sloboste/eecs473-fitness-watch/watch_app/README.md

Sample Dashboard App for Eir Watch
===================================

This sample demonstrates how to use the Bluetooth LE to connect to the Eir Watch with an Android device.

Introduction
------------

This sample shows a list of available Bluetooth LE devices and provides
an interface to connect, display data and display GATT services and
characteristics supported by the devices.

It creates a [Service][1] for managing connection and data communication with a GATT server
hosted on a given Bluetooth LE device.

The Activities communicate with the Service, which in turn interacts with the [Bluetooth LE API][2].

[1]:http://developer.android.com/reference/android/app/Service.html
[2]:https://developer.android.com/reference/android/bluetooth/BluetoothGatt.html

Pre-requisites
--------------

- Android SDK v23
- Android Build Tools v23.0.2
- Android Support Repository

Screenshots
-------------

  

Getting Started
---------------

Create a new project in Android studio and download the files into Application/Src/
