sloboste/eecs473-fitness-watch/docs/SoC/nRF51822-mKIT_Pinout.png

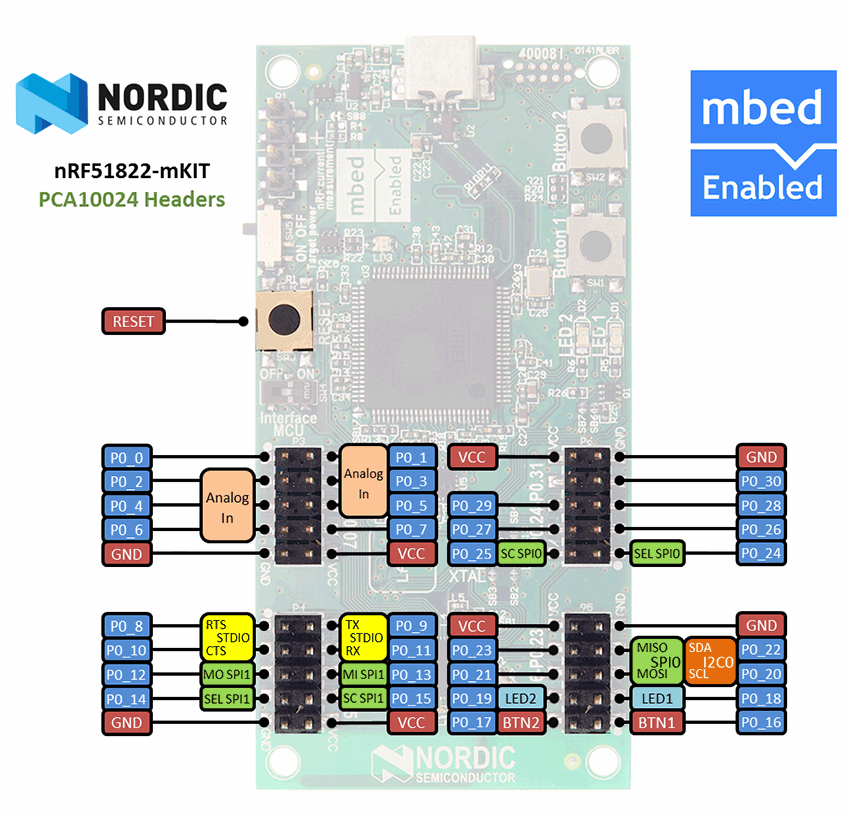
docs/SoC/nRF51822-mKIT_Pinout.png
