sloboste/eecs473-fitness-watch/solidworks/All.SLDASM

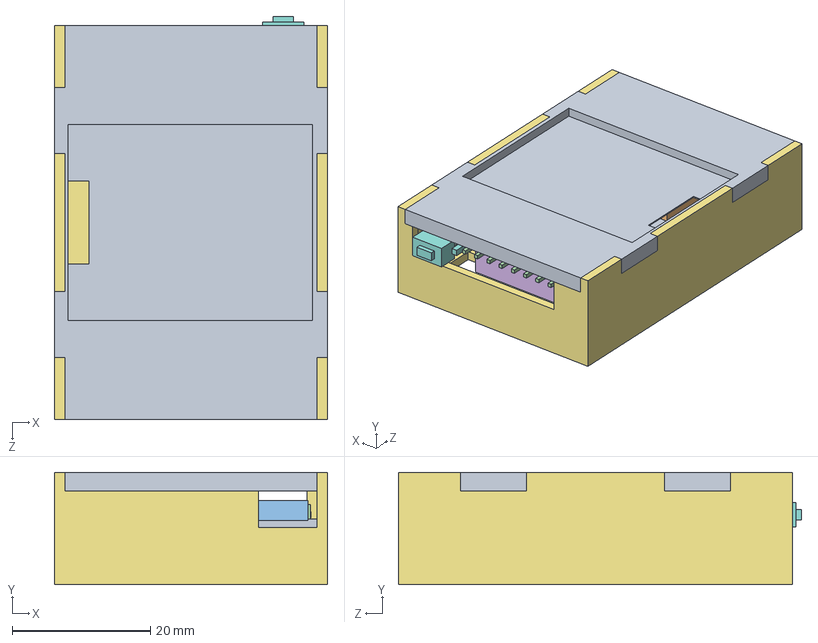
[picture p16: CAD file, 2015-12-03]
solidworks/All.SLDASM
39.5 x 16.2 x 58.3 mm
pcb
gps
microusb
headers
battery_port
battery
bottom_case
button
top_case
