sloboste/eecs473-fitness-watch/solidworks/assembled_pcb.SLDASM

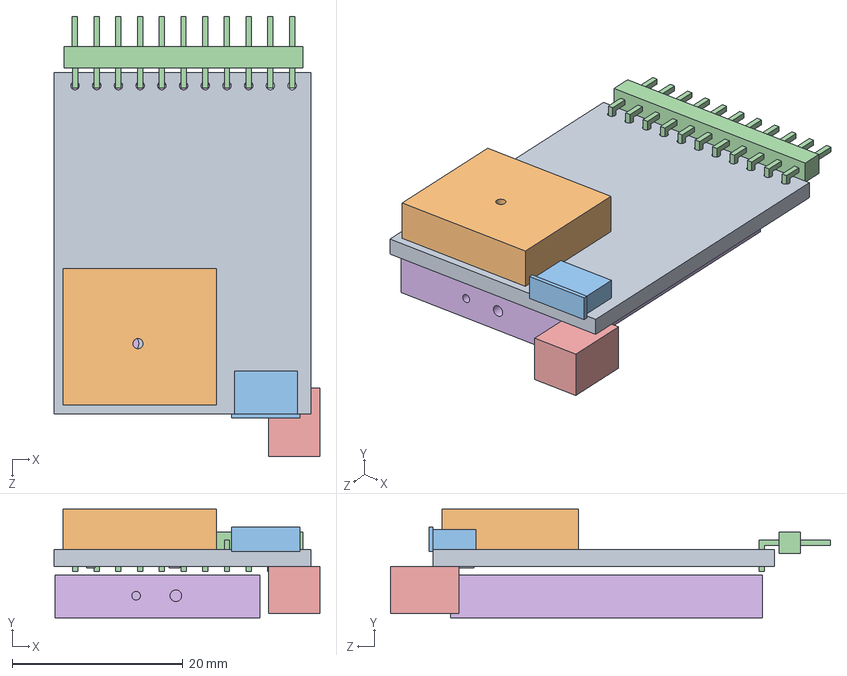
[picture p17: CAD file, 2015-12-03]
solidworks/assembled_pcb.SLDASM
31.1 x 12.7 x 51.5 mm
pcb
gps
microusb
headers
battery_port
battery
