sloboste/eecs473-fitness-watch/solidworks/lcd.SLDPRT

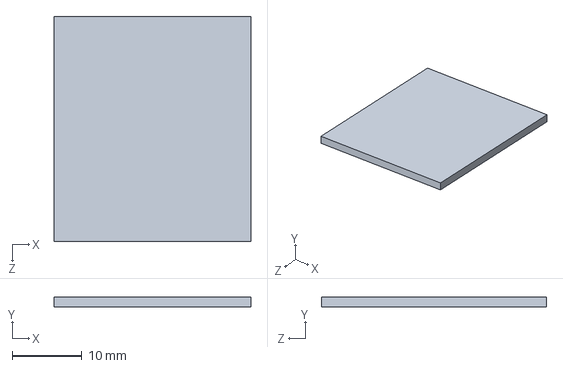
[picture p18: CAD file, 2015-12-03]
solidworks/lcd.SLDPRT
28.2 x 1.50 x 32.2 mm
