sloboste/eecs473-fitness-watch/solidworks/bottom_case.SLDPRT

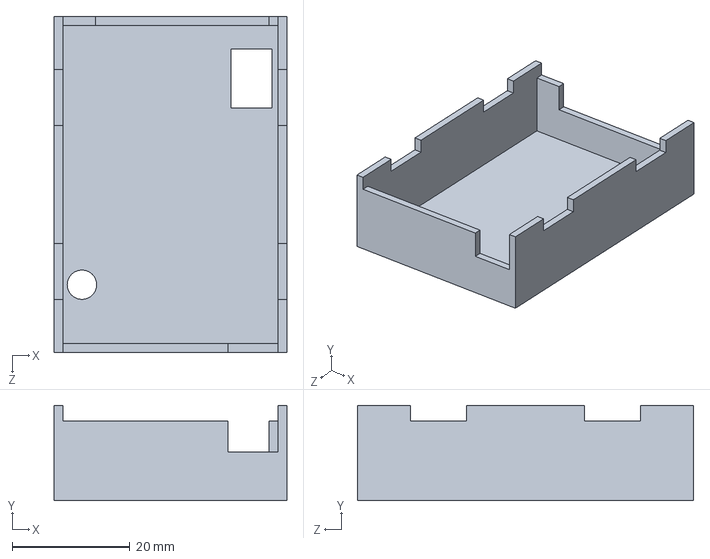
[picture p19: CAD file, 2015-12-03]
solidworks/bottom_case.SLDPRT
39.5 x 16.2 x 57.0 mm
