sloboste/eecs473-fitness-watch/solidworks/top_case.SLDPRT

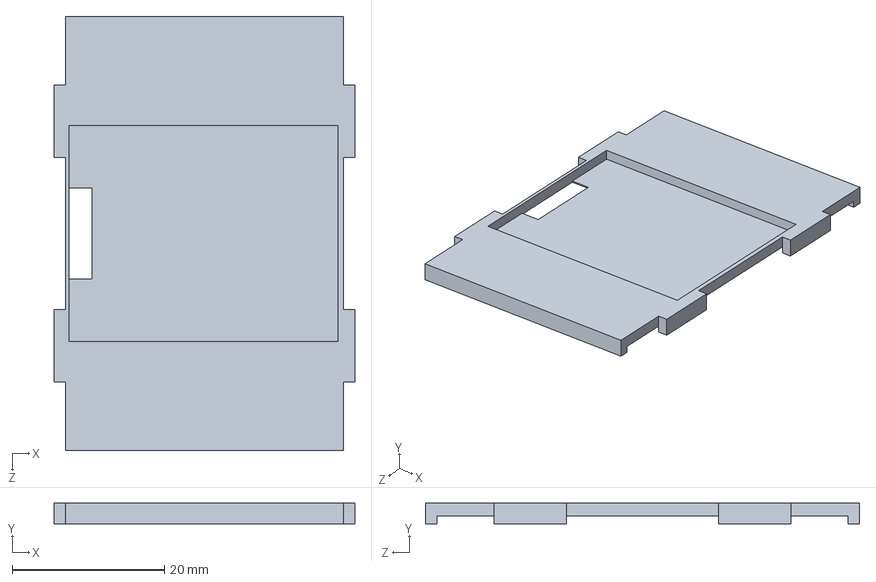
[picture p20: CAD file, 2015-12-03]
solidworks/top_case.SLDPRT
39.5 x 2.70 x 57.0 mm
