sloboste/eecs473-fitness-watch/solidworks/button.SLDPRT

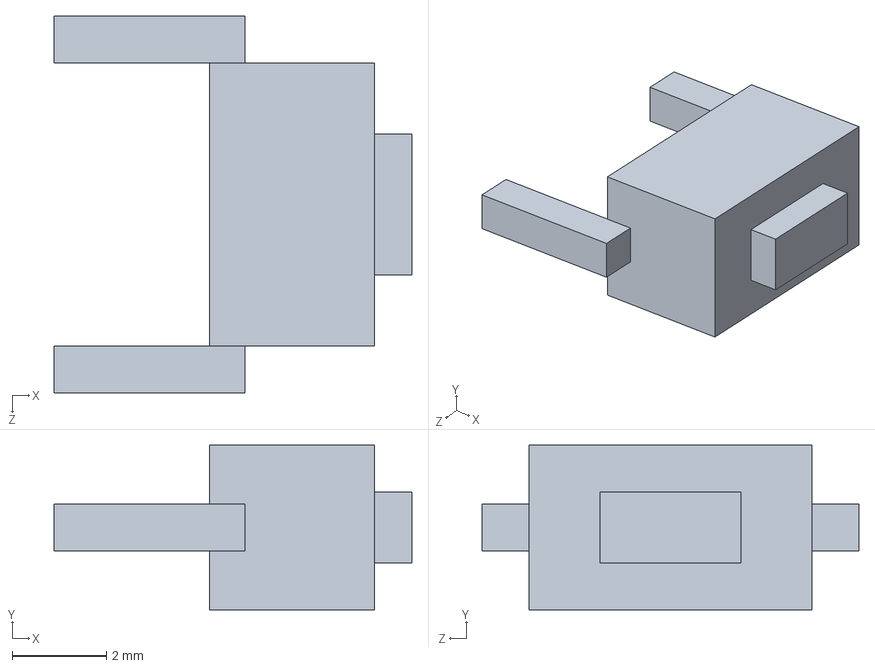
[picture p21: CAD file, 2015-11-10]
solidworks/button.SLDPRT
7.60 x 3.50 x 8.00 mm
