sloboste/eecs473-fitness-watch/solidworks/headers.SLDPRT

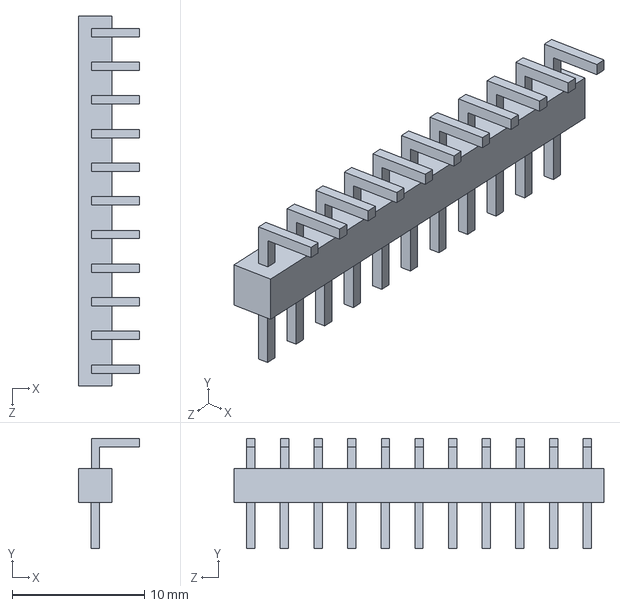
[picture p22: CAD file, 2015-11-10]
solidworks/headers.SLDPRT
4.60 x 8.34 x 27.9 mm
