sloboste/eecs473-fitness-watch/solidworks/pcb.SLDPRT

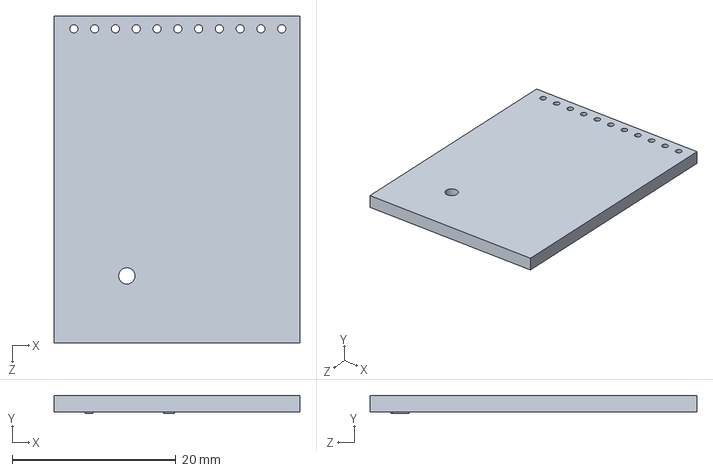
[picture p23: CAD file, 2015-11-10]
solidworks/pcb.SLDPRT
30.1 x 2.20 x 39.9 mm
