sloboste/eecs473-fitness-watch/solidworks/gps.SLDPRT

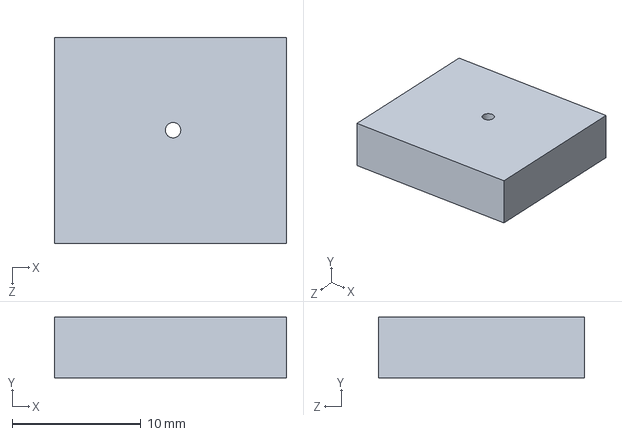
[picture p24: CAD file, 2015-11-10]
solidworks/gps.SLDPRT
18.0 x 4.70 x 16.0 mm
