sloboste/eecs473-fitness-watch/solidworks/battery_port.SLDPRT

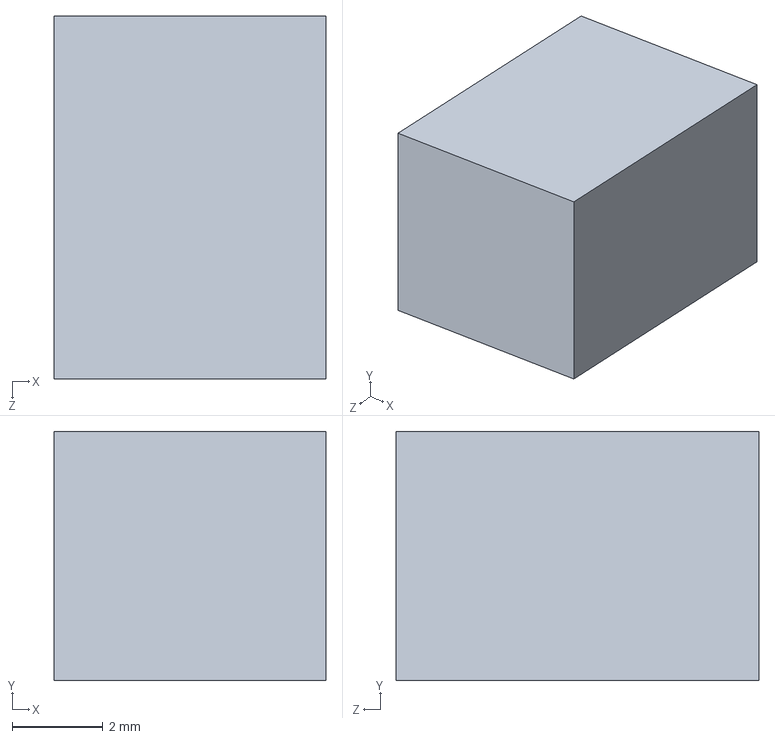
[picture p25: CAD file, 2015-11-10]
solidworks/battery_port.SLDPRT
6.00 x 5.50 x 8.00 mm
