sloboste/eecs473-fitness-watch/solidworks/microusb.SLDPRT

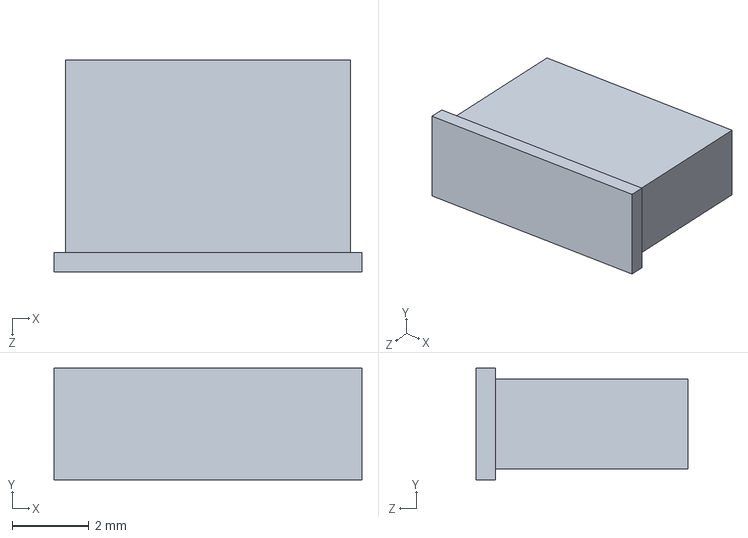
[picture p26: CAD file, 2015-11-10]
solidworks/microusb.SLDPRT
8.00 x 2.90 x 5.50 mm
