sloboste/eecs473-fitness-watch/solidworks/battery.SLDPRT

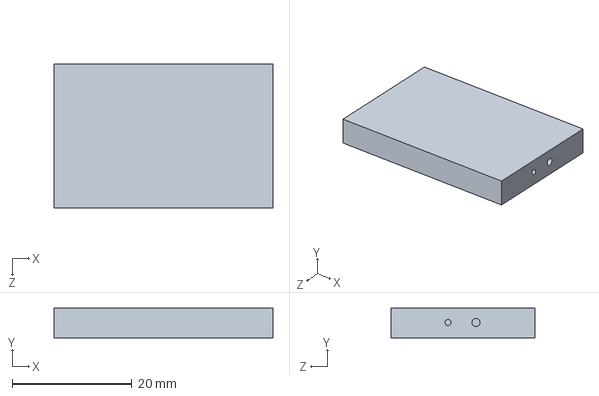
[picture p27: CAD file, 2015-11-10]
solidworks/battery.SLDPRT
36.5 x 5.00 x 24.0 mm
