sloboste/eecs473-fitness-watch/(list of files, cad)

Other CAD files:
solidworks/bottom_case.STL
solidworks/top_case.STL
