sloboste/eecs473-fitness-watch/docs/LCD/lcd_connector.pdf

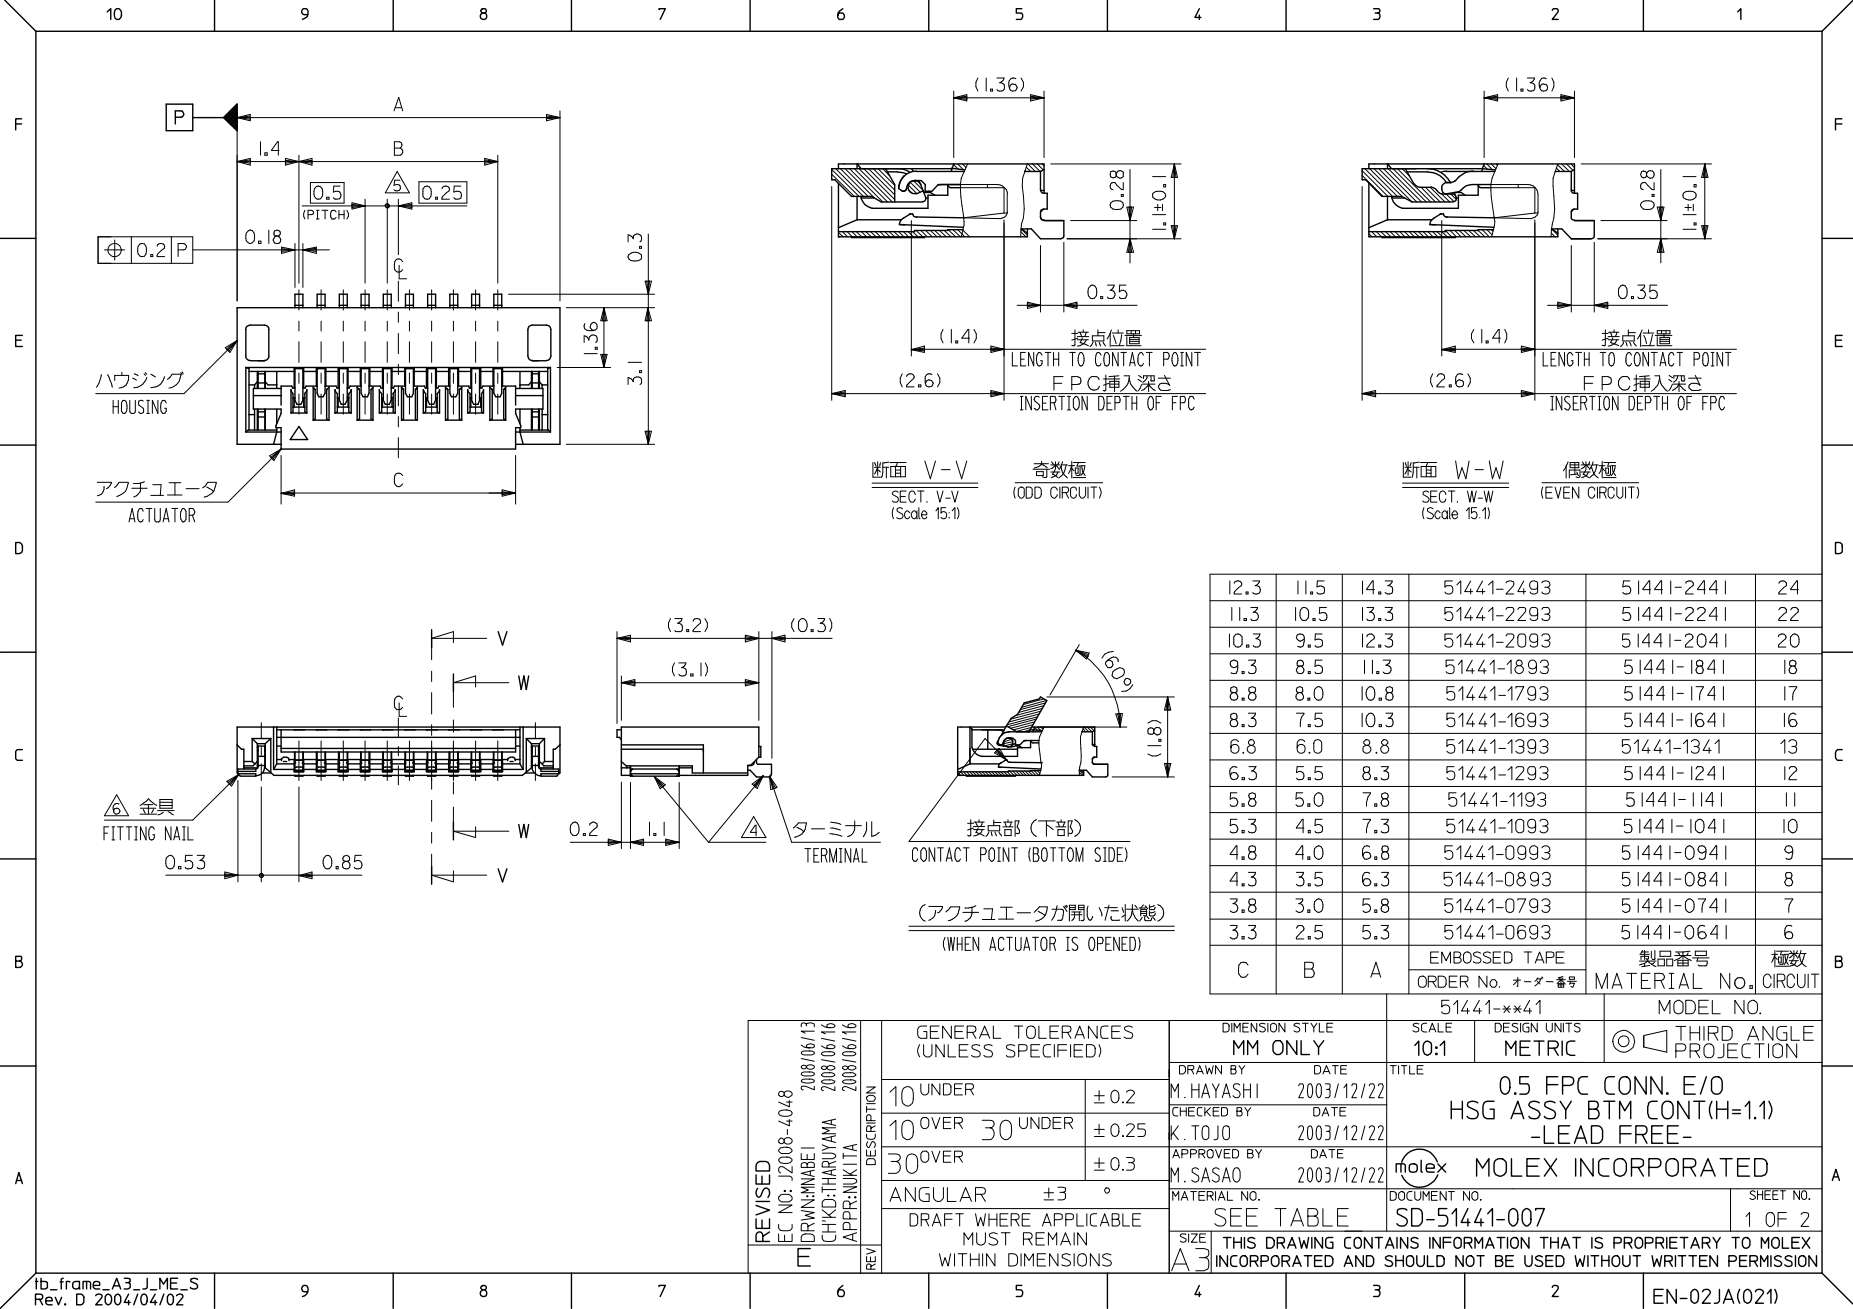
[picture p28: page 1]

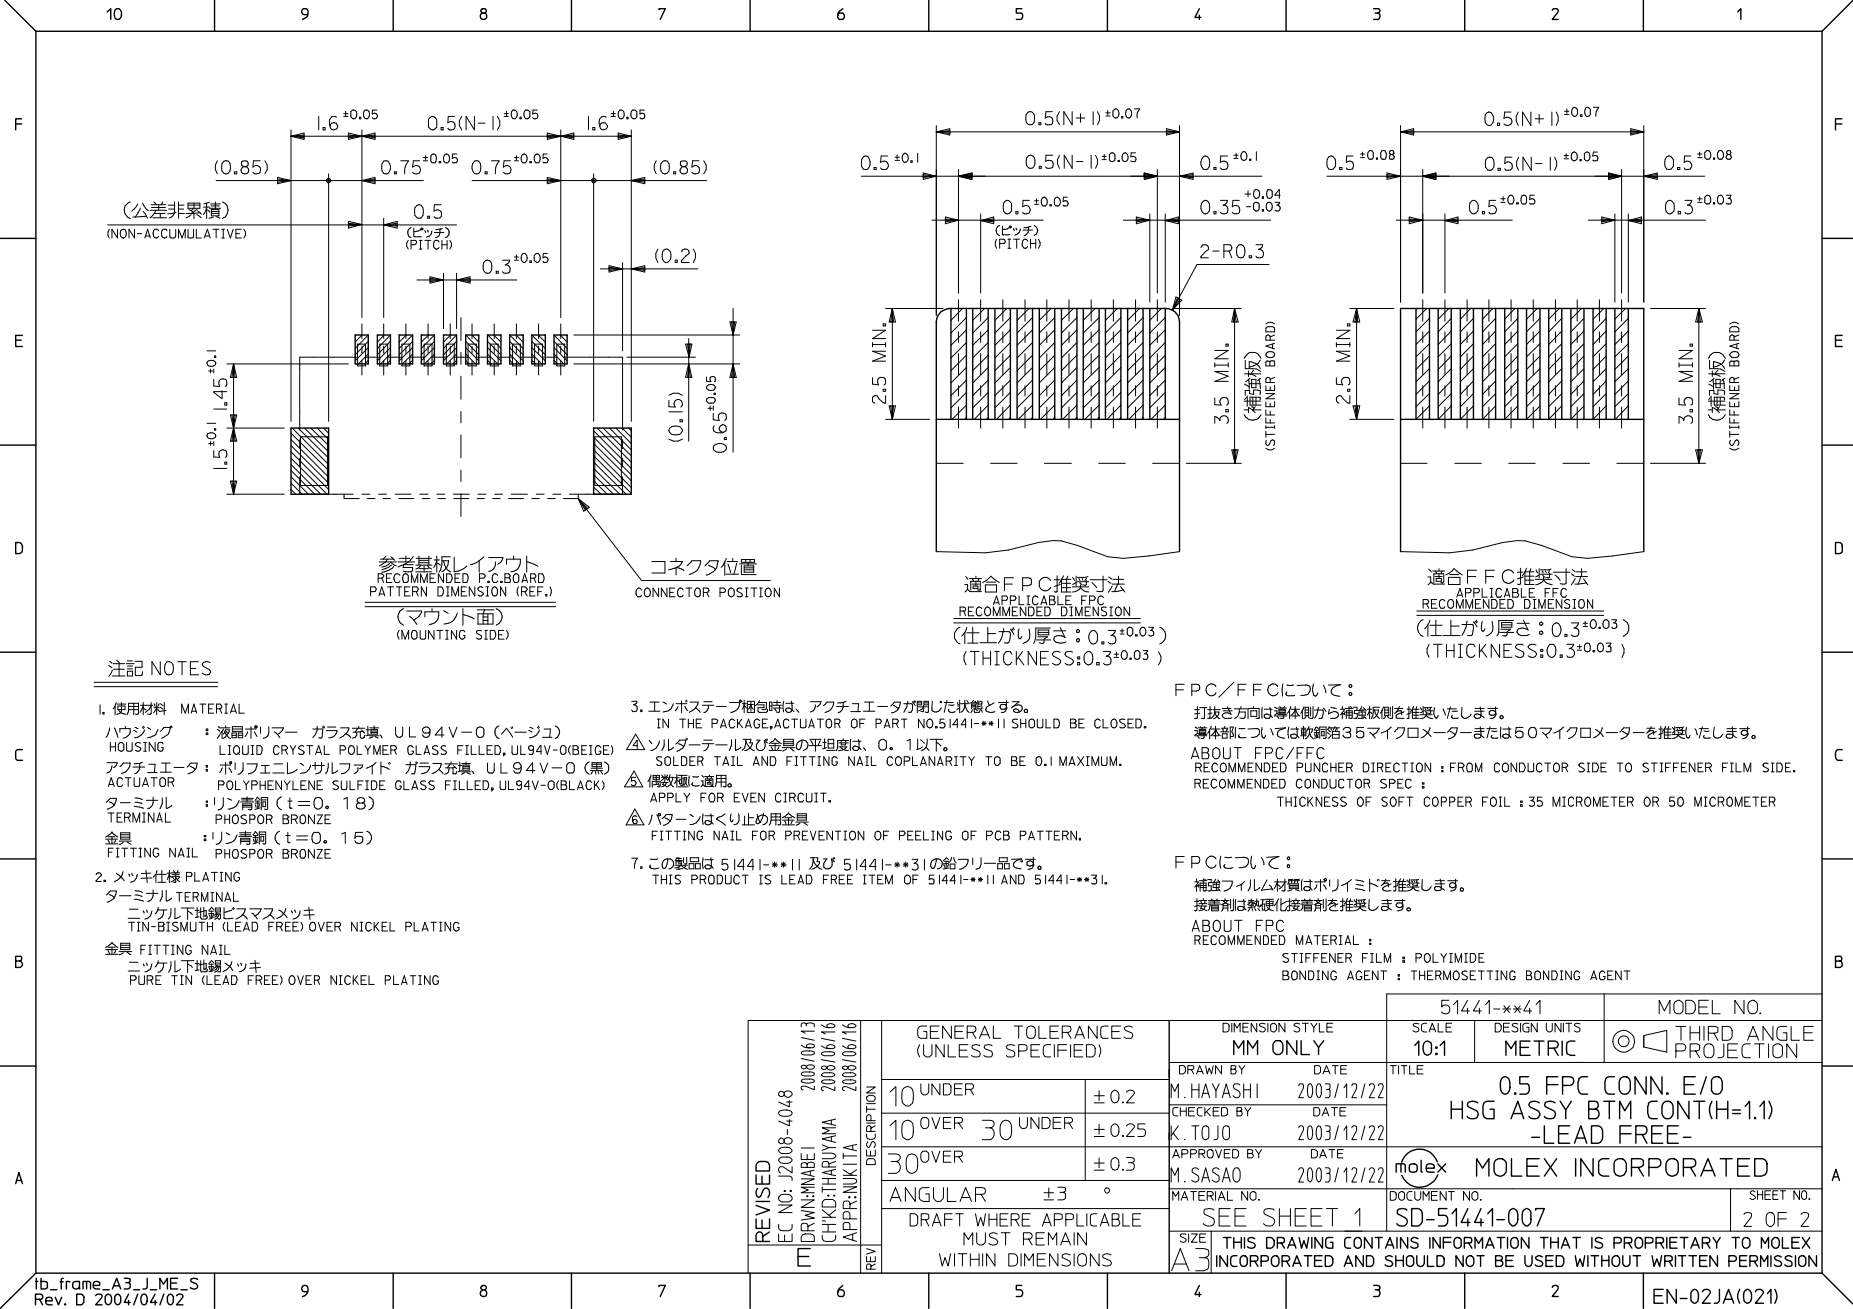
[picture p29: page 2]

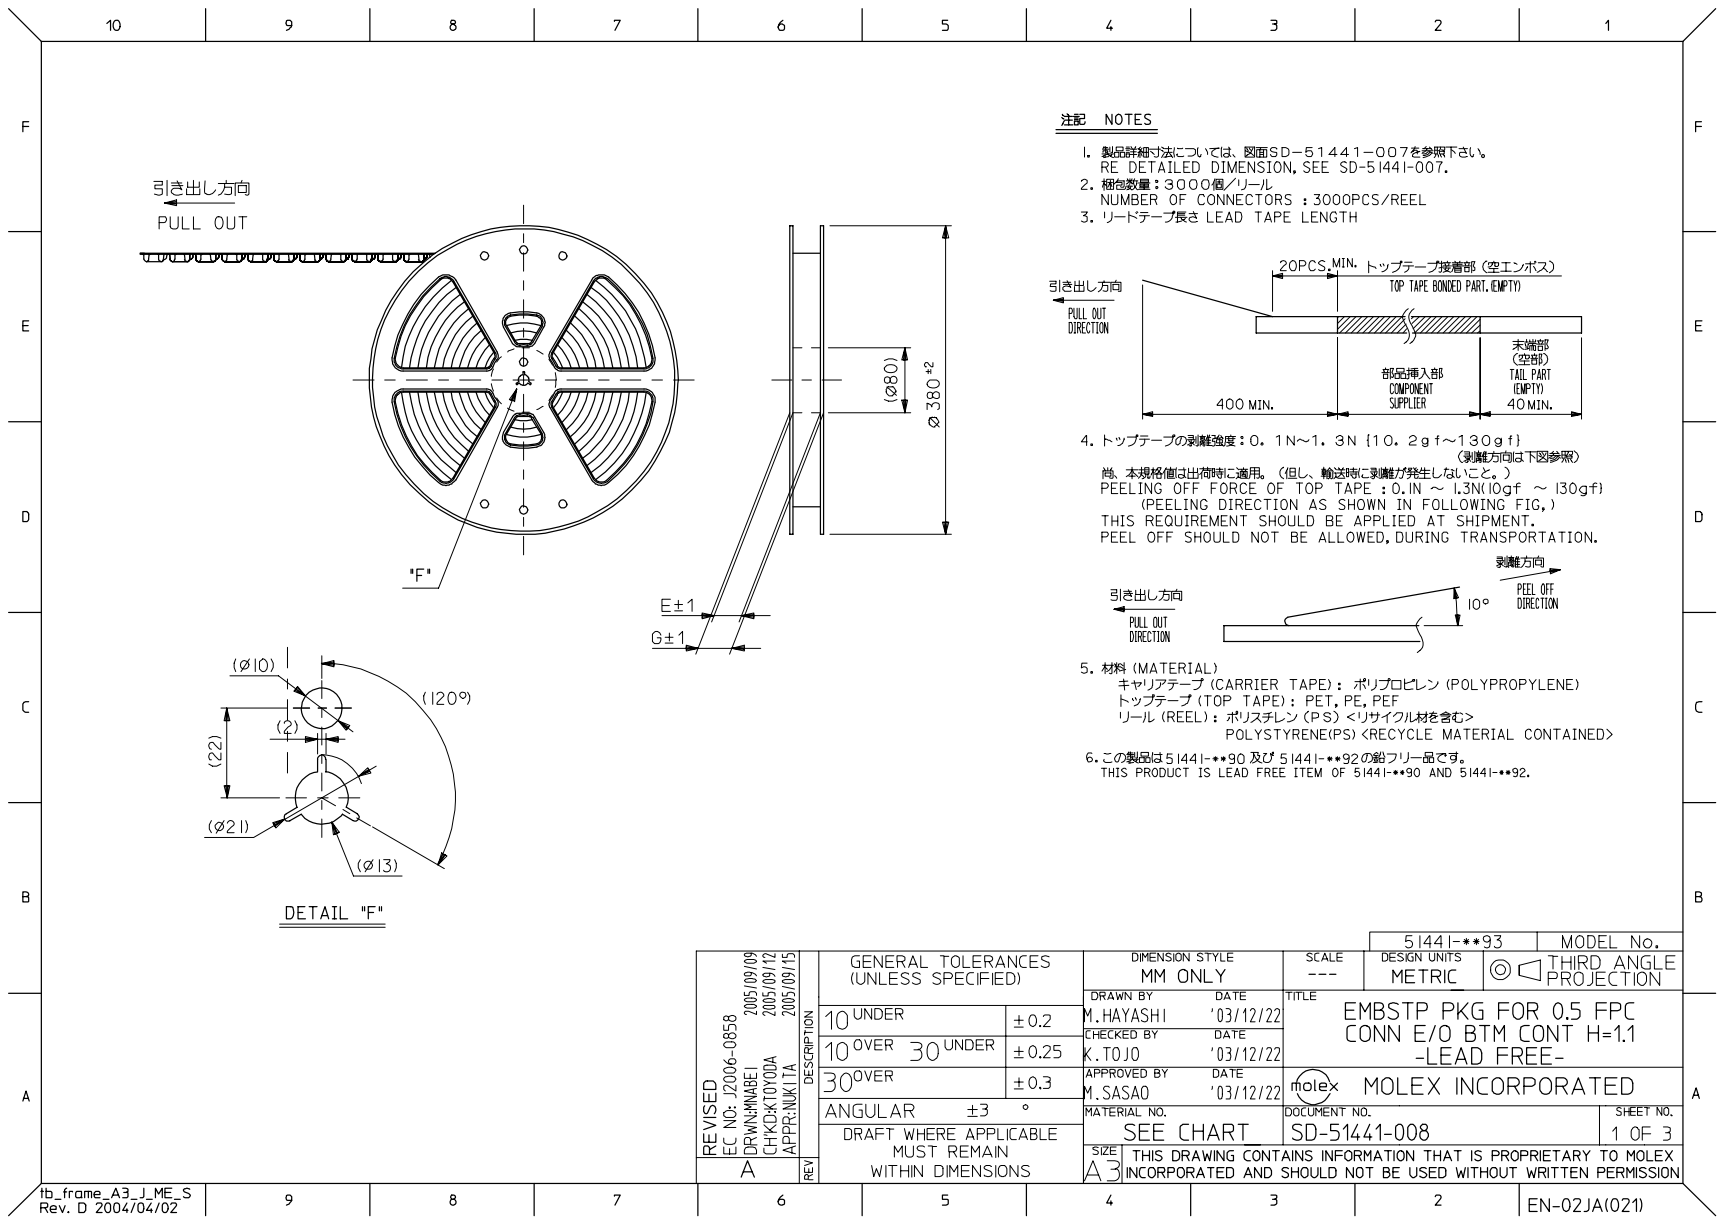
[picture p30: page 3]

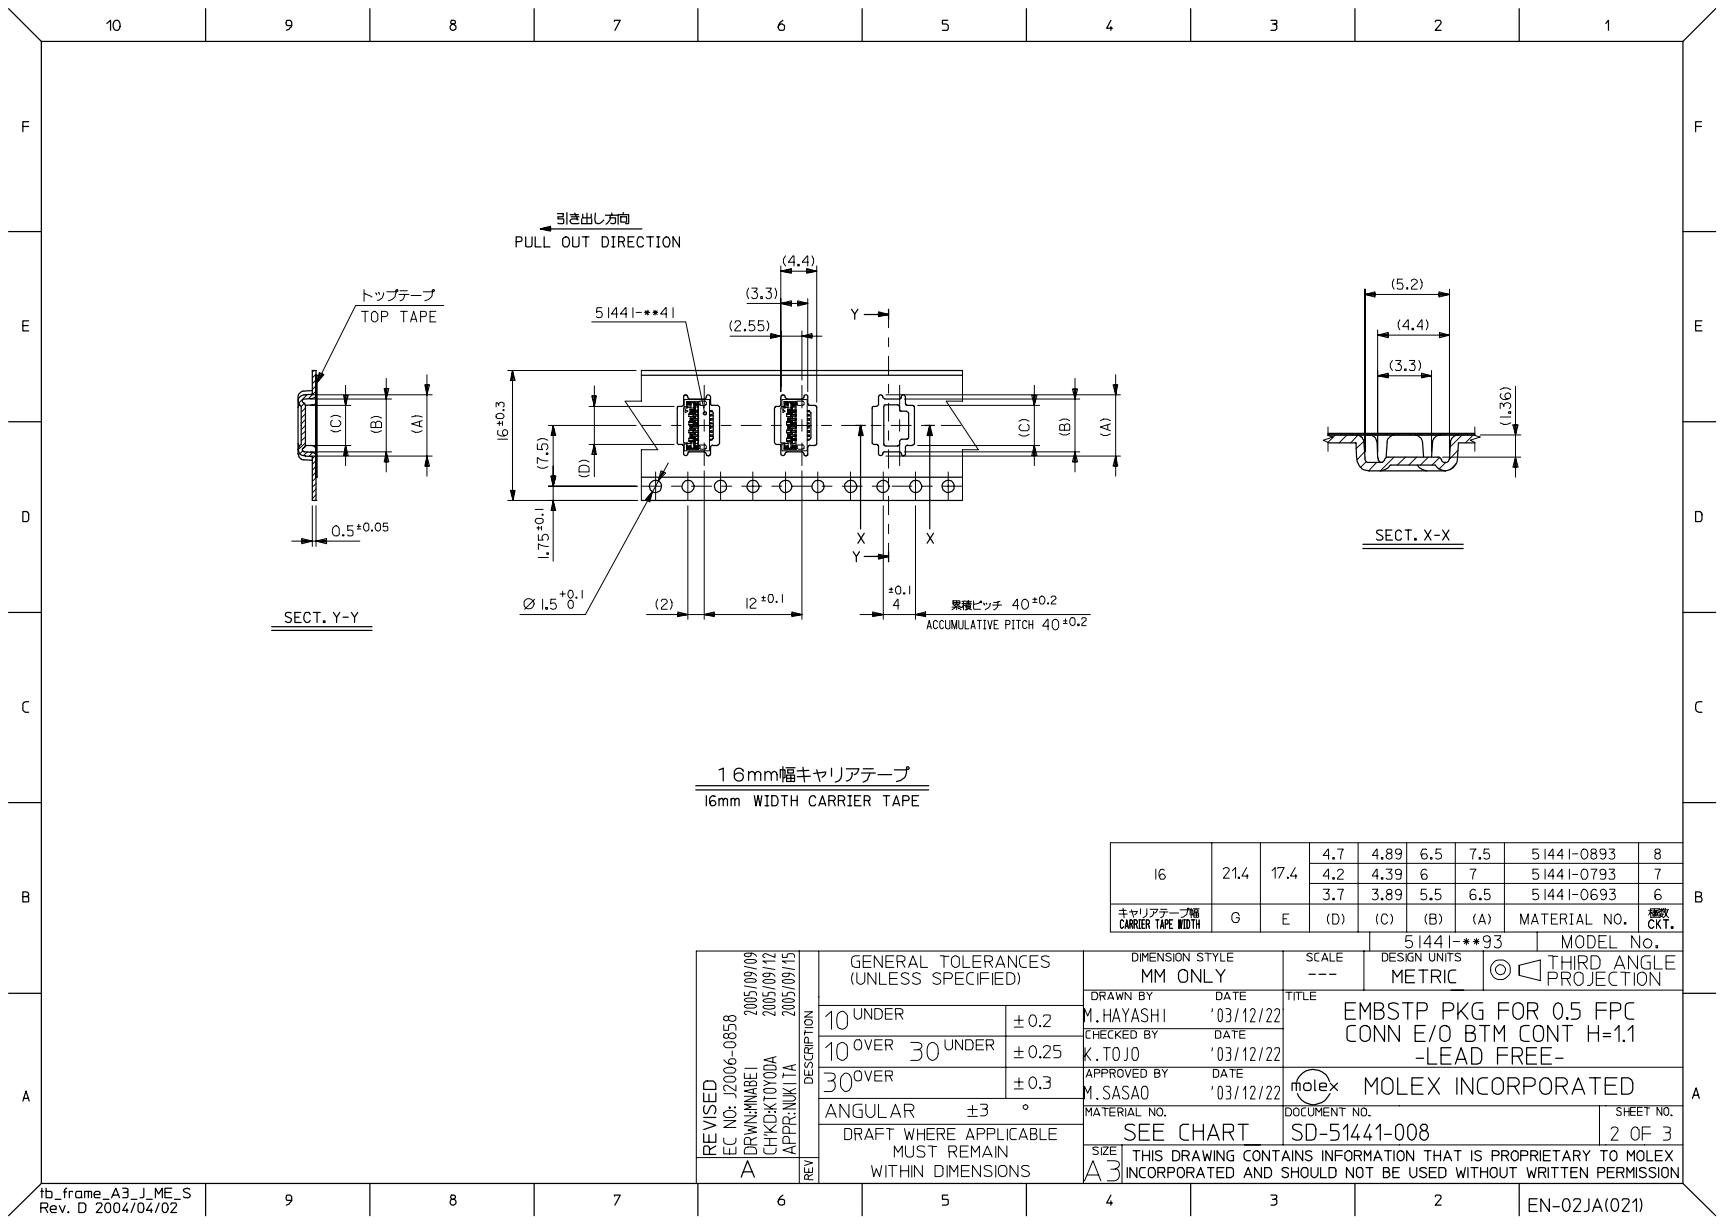
[picture p31: page 4]

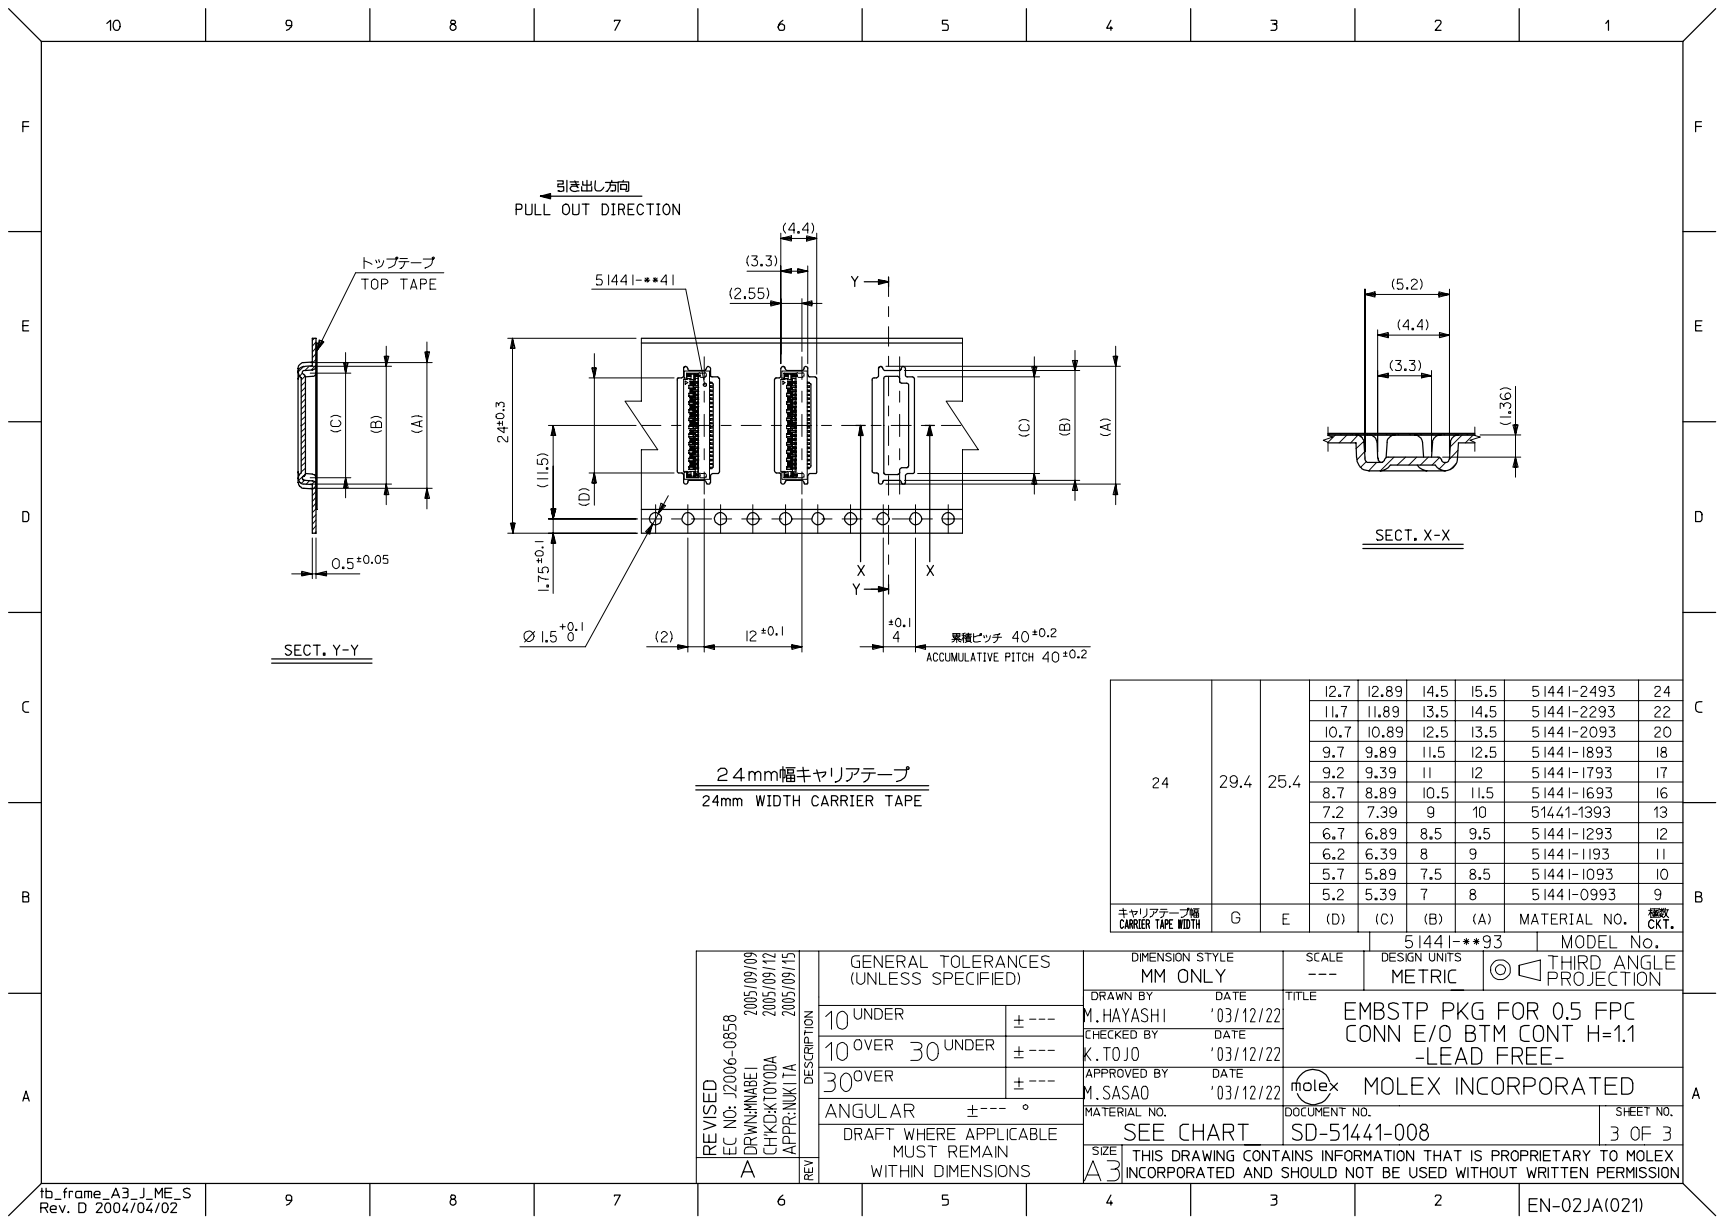
[picture p32: page 5]
