sloboste/eecs473-fitness-watch/EAGLE/project/FitnessBand/fitnessband.pdf

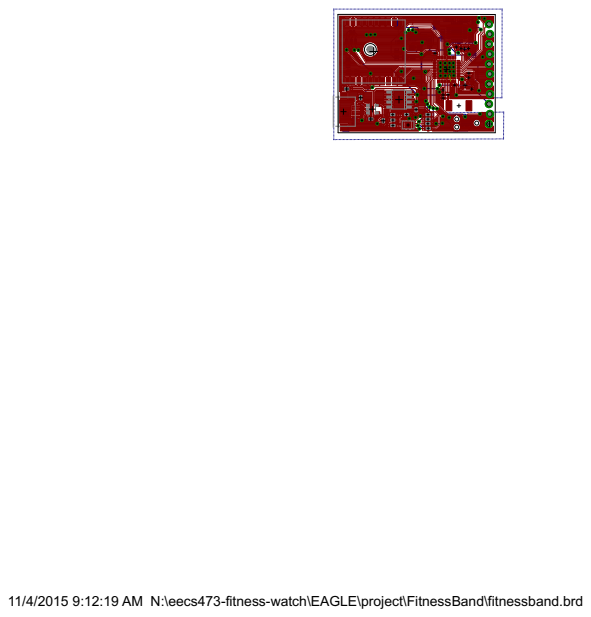
[picture p33: page 1]

11/4/2015 9:12:19 AM N:\eecs473-fitness-watch\EAGLE\project\FitnessBand\fitnessband.brd
