sloboste/eecs473-fitness-watch/EAGLE/project/FitnessBand/fitnessband2.pdf

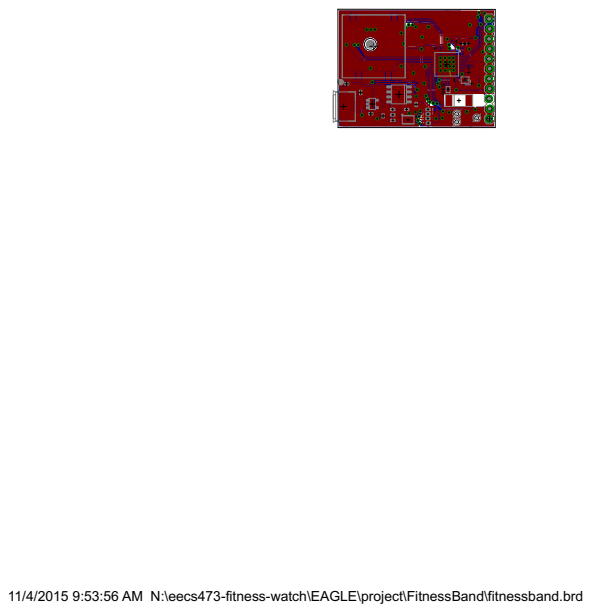
[picture p34: page 1]

11/4/2015 9:53:56 AM N:\eecs473-fitness-watch\EAGLE\project\FitnessBand\fitnessband.brd
