sloboste/eecs473-fitness-watch/EAGLE/project/FitnessBand/fitnessband3.pdf

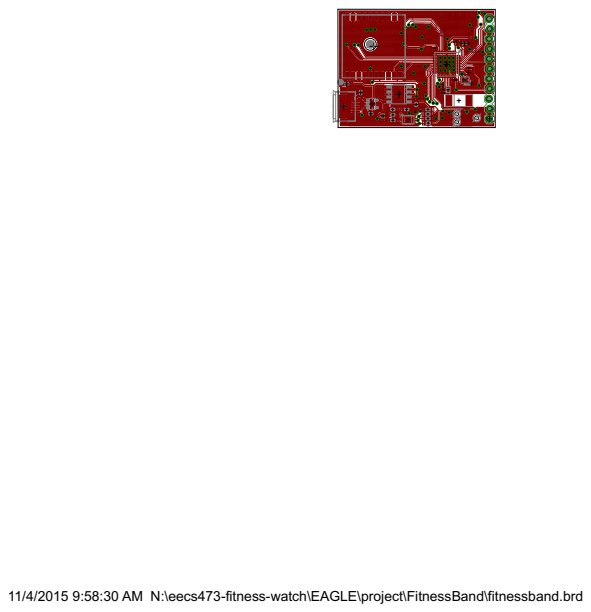
[picture p35: page 1]

11/4/2015 9:58:30 AM N:\eecs473-fitness-watch\EAGLE\project\FitnessBand\fitnessband.brd
