sloboste/eecs473-fitness-watch/EAGLE/project/FitnessBand/fitnessband.brd

## EAGLE design EAGLE/project/FitnessBand/fitnessband.brd (2015-11-25)

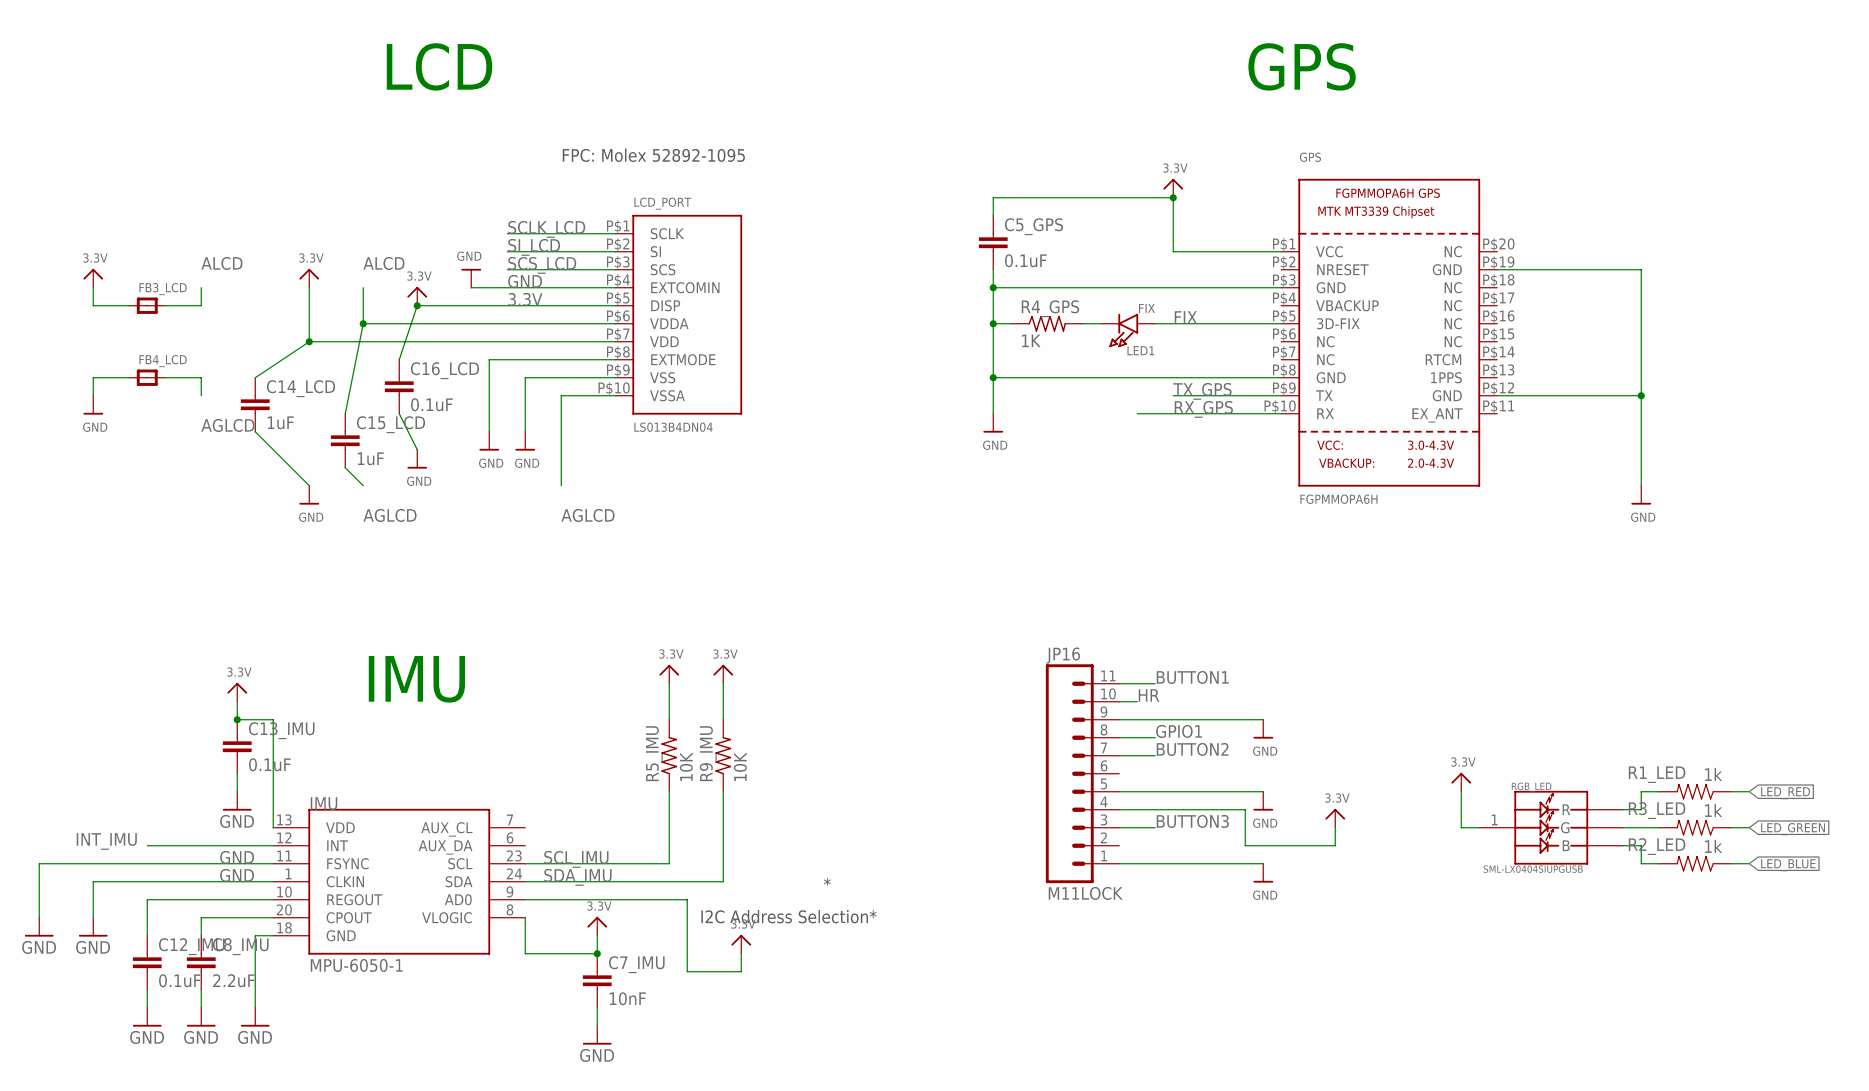
[picture p36: schematic fitnessband.sch, sheet 1]

Parts:
C5_GPS, C12_IMU, C13_IMU, C16_LCD: 0.1uF; C0402
C7_IMU: 10nF; C0402
C8_IMU: 2.2uF; C0402
C14_LCD, C15_LCD: 1uF; C0402
FB3_LCD, FB4_LCD: FERRITE_0805; _0805
GPS: FGPMMOPA6H
IMU: MPU-6050-1; QFN-24-4MM2
JP16: M11LOCK; 1X11_LOCK
LCD_PORT: LS013B4DN04; FPC_10PIN_52892-1095
LED1: FIX; CHIPLED_0805
R1_LED, R2_LED, R3_LED: 1k; 0402_RES
R4_GPS: 1K; R0402
R5_IMU, R9_IMU: 10K; R0402
RGB_LED: SML-LX0404SIUPGUSB; 1MM_SQ_4PAD

Connections:
3.3V: C5_GPS.1, C7_IMU.1, C13_IMU.1, C14_LCD.1, C16_LCD.1, FB3_LCD.1, GPS.P$1 (VCC), IMU.8 (VLOGIC), IMU.9 (AD0), IMU.13 (VDD), JP16.4, LCD_PORT.P$5 (DISP), LCD_PORT.P$7 (VDD), R5_IMU.2, R9_IMU.2, RGB_LED.1 (VDD); also elsewhere on the board
AGLCD: C15_LCD.2, FB4_LCD.2, LCD_PORT.P$10 (VSSA)
ALCD: C15_LCD.1, FB3_LCD.2, LCD_PORT.P$6 (VDDA)
BUTTON1: JP16.11; also elsewhere on the board
BUTTON2: JP16.7; also elsewhere on the board
BUTTON3: JP16.3; also elsewhere on the board
FIX: GPS.P$5 (3D-FIX), LED1.A
GND: C5_GPS.2, C7_IMU.2, C8_IMU.2, C12_IMU.2, C13_IMU.2, C14_LCD.2, C16_LCD.2, FB4_LCD.1, GPS.P$3 (GND), GPS.P$8 (GND), GPS.P$12 (GND), GPS.P$19 (GND), IMU.1 (CLKIN), IMU.11 (FSYNC), IMU.18 (GND), JP16.1, JP16.5, JP16.9, LCD_PORT.P$4 (EXTCOMIN), LCD_PORT.P$8 (EXTMODE), LCD_PORT.P$9 (VSS), R4_GPS.1; also elsewhere on the board
GPIO1: JP16.8; also elsewhere on the board
HR: JP16.10; also elsewhere on the board
INT_IMU: IMU.12 (INT); also elsewhere on the board
LED_BLUE: R2_LED.1; also elsewhere on the board
LED_GREEN: R3_LED.1; also elsewhere on the board
LED_RED: R1_LED.1; also elsewhere on the board
unnamed: R1_LED.2, RGB_LED.2 (R)
unnamed: R3_LED.2, RGB_LED.4 (G)
unnamed: R2_LED.2, RGB_LED.3 (B)
unnamed: LED1.C, R4_GPS.2
unnamed: C8_IMU.1, IMU.20 (CPOUT)
unnamed: C12_IMU.1, IMU.10 (REGOUT)
RX_GPS: GPS.P$10 (RX); also elsewhere on the board
SCLK_LCD: LCD_PORT.P$1 (SCLK); also elsewhere on the board
SCL_IMU: IMU.23 (SCL), R5_IMU.1; also elsewhere on the board
SCS_LCD: LCD_PORT.P$3 (SCS); also elsewhere on the board
SDA_IMU: IMU.24 (SDA), R9_IMU.1; also elsewhere on the board
SI_LCD: LCD_PORT.P$2 (SI); also elsewhere on the board
TX_GPS: GPS.P$9 (TX); also elsewhere on the board

Notes on the sheet:
FPC: Molex 52892-1095
LCD
GPS
I2C Address Selection*
IMU

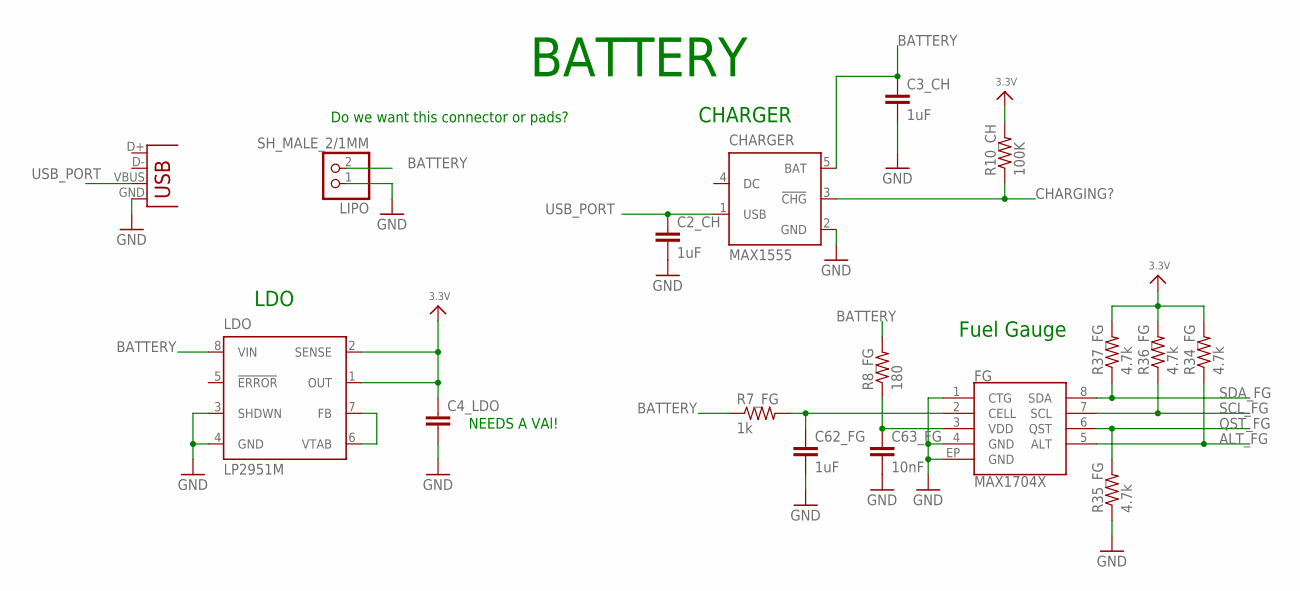
[picture p37: schematic fitnessband.sch, sheet 2]

Parts:
C2_CH, C3_CH: 1uF; C0402
C4_LDO: C-EUC0402; C0402
C62_FG: 1uF; 0402-CAP
C63_FG: 10nF; 0402-CAP
CHARGER: MAX1555; SOT23-5L
FG: MAX1704X; TDFN-8
LDO: LP2951M; SO08
LIPO: SH_MALE_2/1MM; SH-1X2/1MM
R7_FG: 1k; 0402-RES
R8_FG: 180; 0402-RES
R10_CH: 100K; R0402
R34_FG, R35_FG, R36_FG, R37_FG: 4.7k; 0402-RES
X5: USB-MICROB

Connections:
3.3V: C4_LDO.1, LDO.1 (OUT), LDO.2 (SENSE), R10_CH.2, R34_FG.2, R36_FG.2, R37_FG.2; also elsewhere on the board
ALT_FG: FG.5 (ALT), R34_FG.1; also elsewhere on the board
BATTERY: C3_CH.1, CHARGER.5 (BAT), LDO.8 (VIN), LIPO.2, R7_FG.1, R8_FG.2
CHARGING?: CHARGER.3 (!CHG), R10_CH.1; also elsewhere on the board
GND: C2_CH.2, C3_CH.2, C4_LDO.2, C62_FG.2, C63_FG.2, CHARGER.2 (GND), FG.1 (CTG), FG.4 (GND), FG.EP (GND), LDO.3 (SHDWN), LDO.4 (GND), LIPO.1, R35_FG.1, X5.GND; also elsewhere on the board
unnamed: LDO.6 (VTAB), LDO.7 (FB)
unnamed: C62_FG.1, FG.2 (CELL), R7_FG.2
QST_FG: FG.6 (QST), R35_FG.2; also elsewhere on the board
SCL_FG: FG.7 (SCL), R36_FG.1; also elsewhere on the board
SDA_FG: FG.8 (SDA), R37_FG.1; also elsewhere on the board
USB_PORT: C2_CH.1, CHARGER.1 (USB), X5.VBUS
VDD: C63_FG.1, FG.3 (VDD), R8_FG.1

Notes on the sheet:
Do we want this connector or pads?
BATTERY
LDO
CHARGER
NEEDS A VAl!
Fuel Gauge

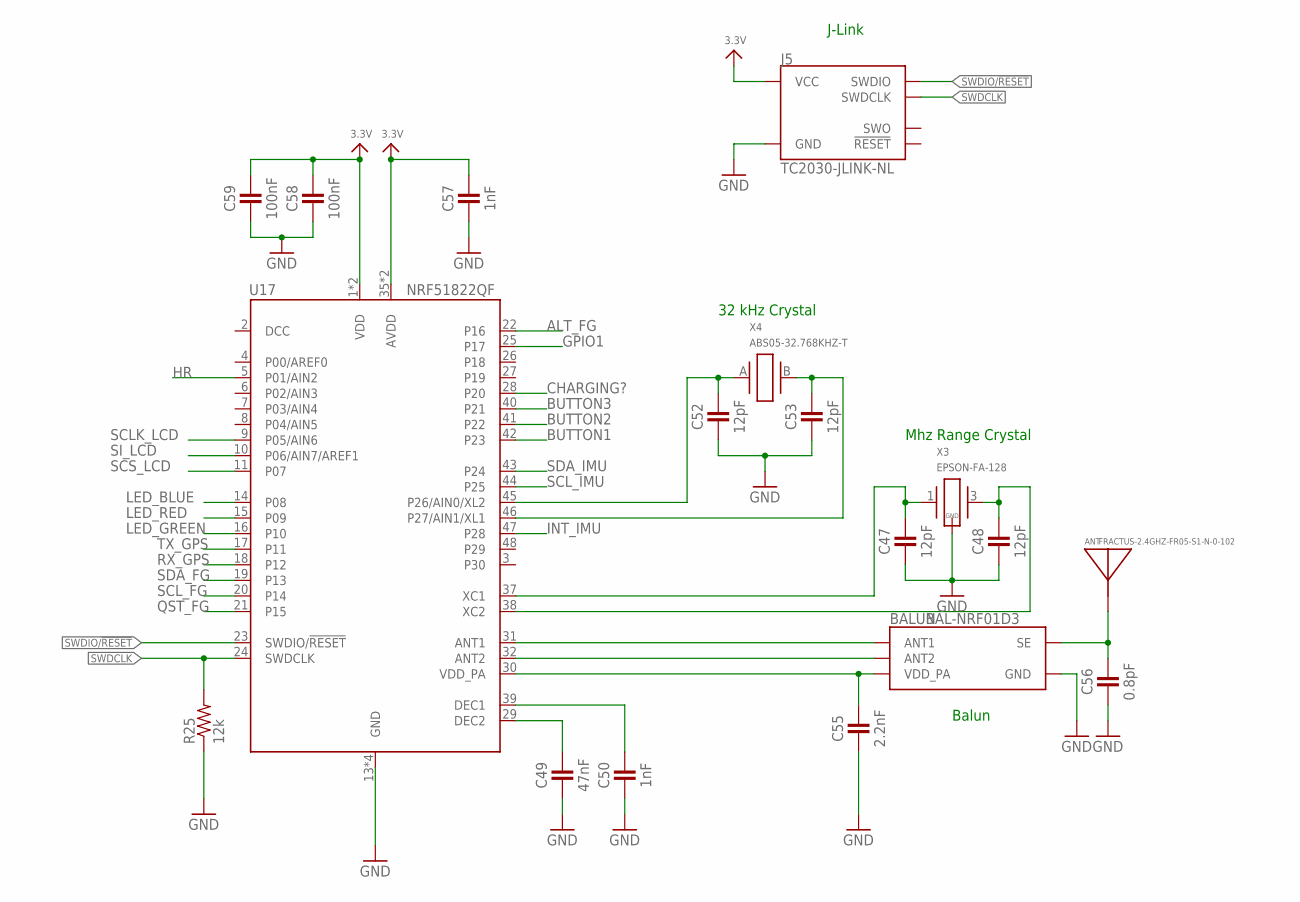
[picture p38: schematic fitnessband.sch, sheet 3]

Parts:
ANT: FRACTUS-2.4GHZ-FR05-S1-N-0-102; FRACTUS-ANTENNA-FR05-S1-N-0-102
BALUN: BAL-NRF01D3
C47, C48, C52, C53: 12pF; 0402_CAP
C49: 47nF; 0402_CAP
C50, C57: 1nF; 0402_CAP
C55: 2.2nF; 0402_CAP
C56: 0.8pF; 0402_CAP
C58, C59: 100nF; 0402_CAP
J5: TC2030-JLINK-NL; TC2030-IDC-NL
R25: 12k; 0402_RES
U17: NRF51822QF; QFN-48-6MM
X3: EPSON-FA-128; FA-128
X4: ABS05-32.768KHZ-T; ABS05

Connections:
3.3V: C57.1, C58.1, C59.1, J5.1 (VCC), U17.1 (VDD), U17.12 (VDD), U17.35 (AVDD), U17.36 (AVDD); also elsewhere on the board
ALT_FG: U17.22 (P16); also elsewhere on the board
ANTENNA1: ANT.1, BALUN.SE, C56.1
BUTTON1: U17.42 (P23); also elsewhere on the board
BUTTON2: U17.41 (P22); also elsewhere on the board
BUTTON3: U17.40 (P21); also elsewhere on the board
CHARGING?: U17.28 (P20); also elsewhere on the board
GND: BALUN.GND, C47.2, C48.2, C49.2, C50.2, C52.2, C53.2, C55.2, C56.2, C57.2, C58.2, C59.2, J5.5 (GND), R25.1, U17.13 (GND), U17.33 (GND), U17.34 (GND), U17.GND, X3.2 (GND), X3.4 (GND); also elsewhere on the board
GPIO1: U17.25 (P17); also elsewhere on the board
HR: U17.5 (P01/AIN2); also elsewhere on the board
INT_IMU: U17.47 (P28); also elsewhere on the board
LED_BLUE: U17.14 (P08); also elsewhere on the board
LED_GREEN: U17.16 (P10); also elsewhere on the board
LED_RED: U17.15 (P09); also elsewhere on the board
unnamed: C47.1, U17.37 (XC1), X3.1
unnamed: C48.1, U17.38 (XC2), X3.3 (2)
unnamed: C49.1, U17.29 (DEC2)
unnamed: C52.1, U17.45 (P26/AIN0/XL2), X4.A (1)
unnamed: C53.1, U17.46 (P27/AIN1/XL1), X4.B (2)
unnamed: C50.1, U17.39 (DEC1)
unnamed: BALUN.ANT1, U17.31 (ANT1)
unnamed: BALUN.ANT2, U17.32 (ANT2)
unnamed: BALUN.VCC (VDD_PA), C55.1, U17.30 (VDD_PA)
QST_FG: U17.21 (P15); also elsewhere on the board
RX_GPS: U17.18 (P12); also elsewhere on the board
SCLK_LCD: U17.9 (P05/AIN6); also elsewhere on the board
SCL_FG: U17.20 (P14); also elsewhere on the board
SCL_IMU: U17.44 (P25); also elsewhere on the board
SCS_LCD: U17.11 (P07); also elsewhere on the board
SDA_FG: U17.19 (P13); also elsewhere on the board
SDA_IMU: U17.43 (P24); also elsewhere on the board
SI_LCD: U17.10 (P06/AIN7/AREF1); also elsewhere on the board
SWDCLK: J5.4 (SWDCLK), R25.2, U17.24 (SWDCLK)
SWDIO/!RESET: J5.2 (SWDIO), U17.23 (SWDIO/!RESET)
TX_GPS: U17.17 (P11); also elsewhere on the board

Notes on the sheet:
J-Link
Balun
Mhz Range Crystal
32 kHz Crystal

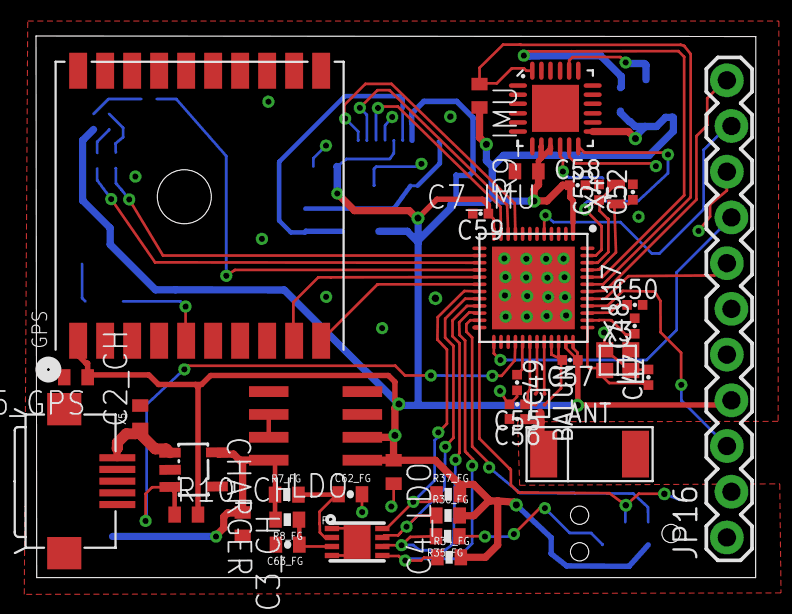
[picture p39: board fitnessband.brd from above]

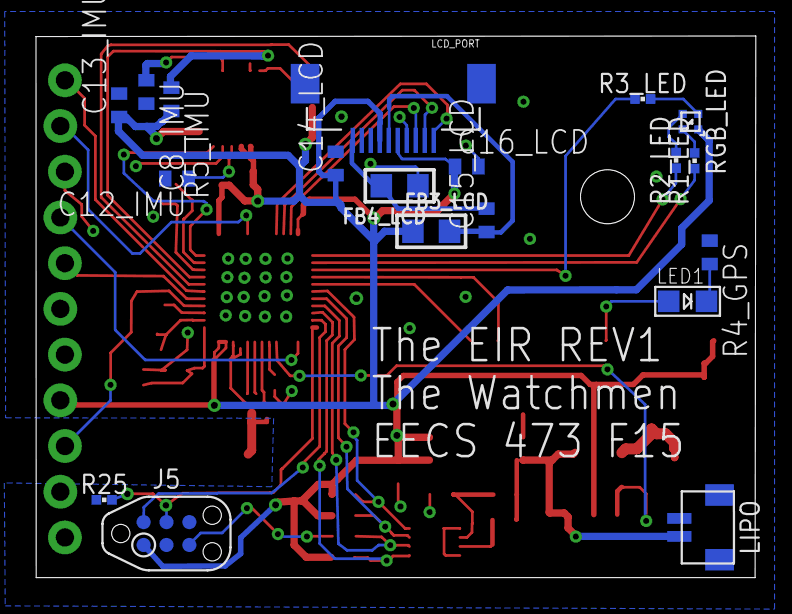
[picture p40: board fitnessband.brd from below]

Board: 2 copper layers, 40.0 x 30.1 mm, 57 parts (19 on the bottom side), 49 nets.
