sloboste/eecs473-fitness-watch/EAGLE/project/473/nucleum.brd

## EAGLE design EAGLE/project/473/nucleum.brd (2015-11-10)

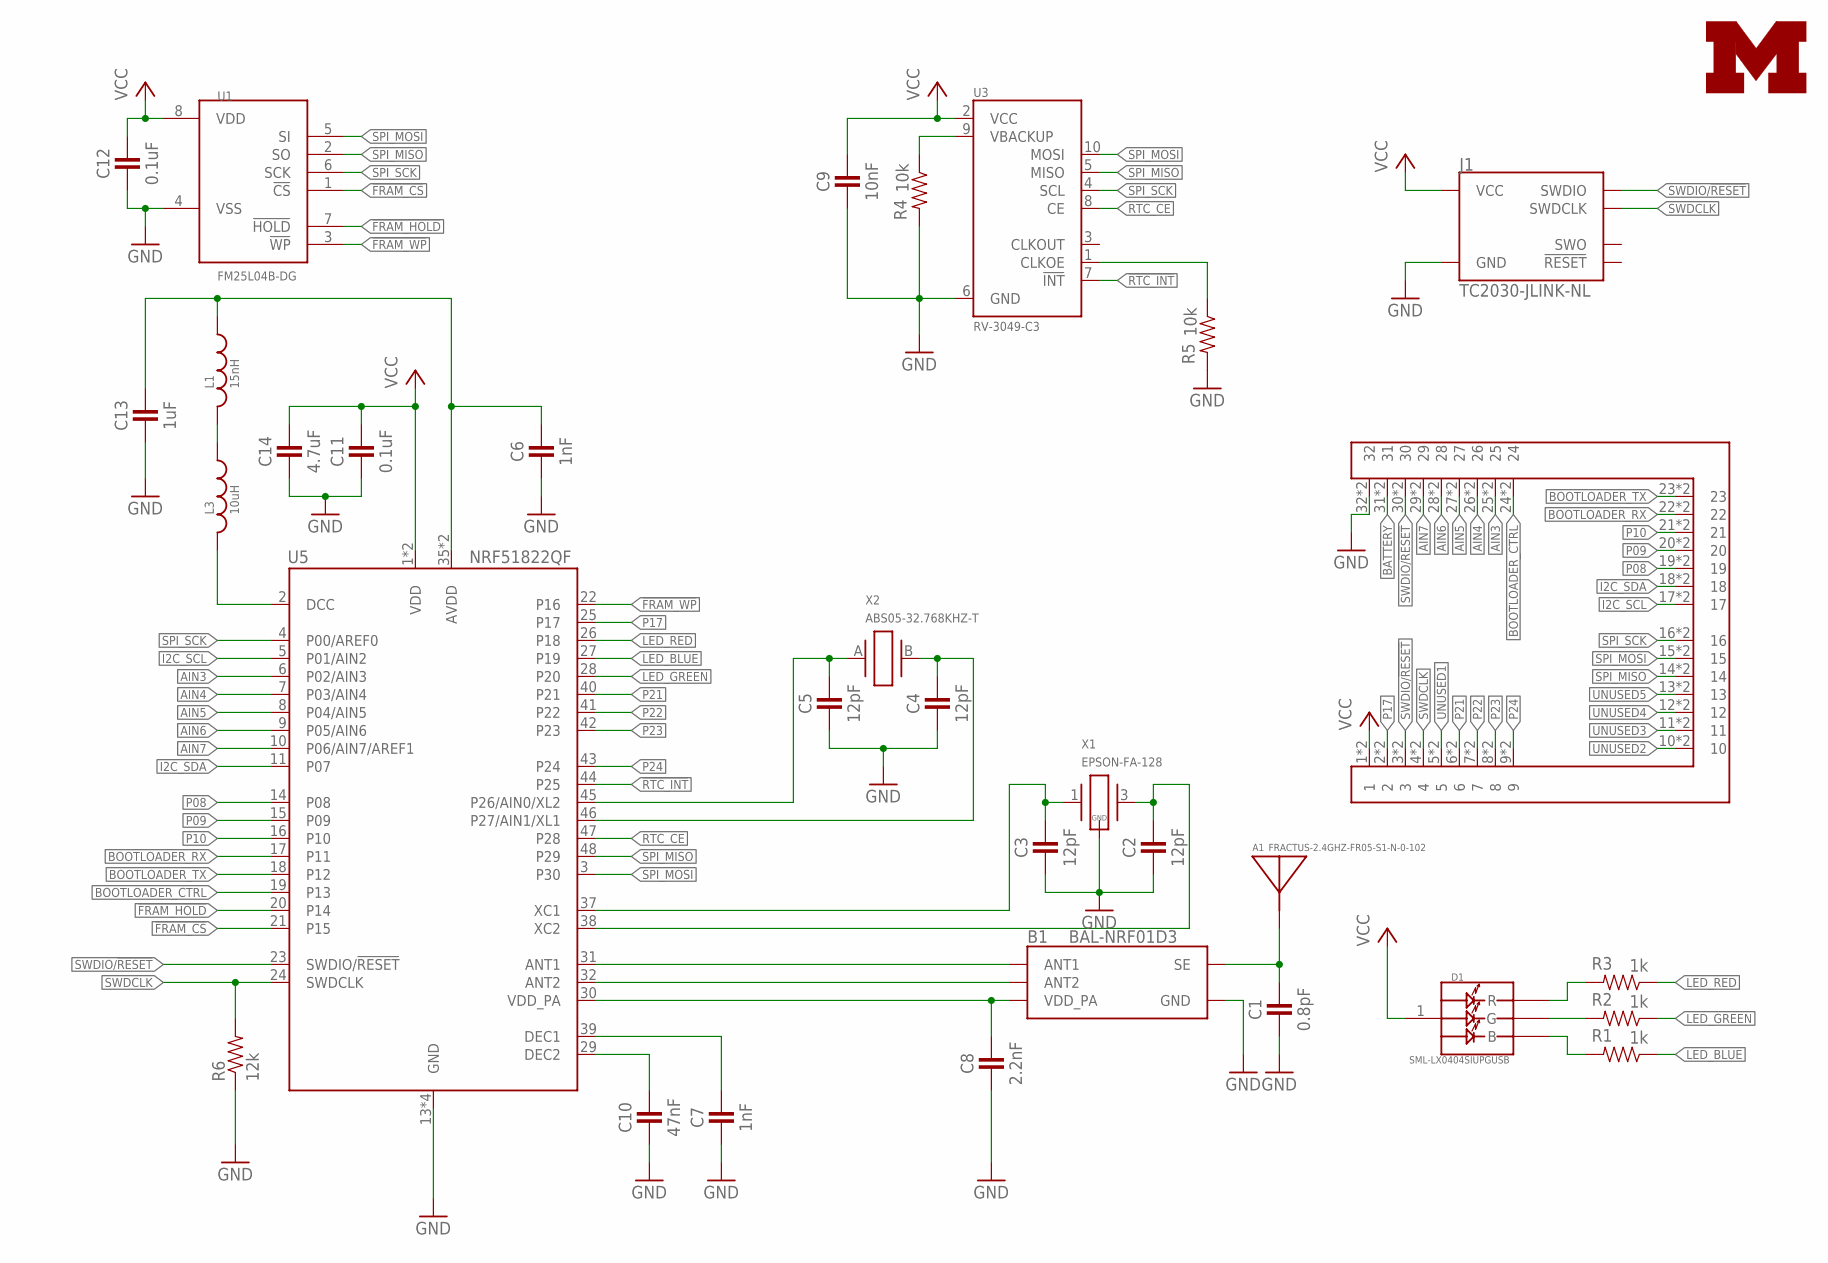
[picture p41: schematic nucleum.sch, sheet 1]

Parts:
A1: FRACTUS-2.4GHZ-FR05-S1-N-0-102; FRACTUS-ANTENNA-FR05-S1-N-0-102
B1: BAL-NRF01D3
C1: 0.8pF; 0402_CAP
C2, C3, C4, C5: 12pF; 0402_CAP
C6, C7: 1nF; 0402_CAP
C8: 2.2nF; 0402_CAP
C9: 10nF; 0402_CAP
C10: 47nF; 0402_CAP
C11, C12: 0.1uF; 0402_CAP
C13: 1uF; 0402_CAP
C14: 4.7uF; 0402_CAP
D1: SML-LX0404SIUPGUSB; 1MM_SQ_4PAD
J1: TC2030-JLINK-NL; TC2030-IDC-NL
J3: ATUM-HEADER
L1: 15nH; 0402_CAP
L3: 10uH; 0603_CAP
LOGO1: UMICH_SOLID_TINY; UMICH_SOLID_50MIL
R1, R2, R3: 1k; 0402_RES
R4, R5: 10k; 0402_RES
R6: 12k; 0402_RES
U1: FM25L04B-DG; TDFN-8
U3: RV-3049-C3; MICRO-CRYSTAL-C3
U5: NRF51822QF; QFN-48-6MM
X1: EPSON-FA-128; FA-128
X2: ABS05-32.768KHZ-T; ABS05

Connections:
!FRAM_CS: U1.1 (!CS), U5.21 (P15)
!FRAM_HOLD: U1.7 (!HOLD), U5.20 (P14)
!FRAM_WP: U1.3 (!WP), U5.22 (P16)
!RTC_INT: U3.7 (!INT), U5.44 (P25)
AIN3: J3.25, J3.25B (25), U5.6 (P02/AIN3)
AIN4: J3.26, J3.26B (26), U5.7 (P03/AIN4)
AIN5: J3.27, J3.27B (27), U5.8 (P04/AIN5)
AIN6: J3.28, J3.28B (28), U5.9 (P05/AIN6)
AIN7: J3.29, J3.29B (29), U5.10 (P06/AIN7/AREF1)
ANTENNA: A1.1, B1.SE, C1.1
BATTERY: J3.31, J3.31B (31); also elsewhere on the board
BOOTLOADER_CTRL: J3.24, J3.24B (24), U5.19 (P13)
BOOTLOADER_RX: J3.22, J3.22B (22), U5.17 (P11)
BOOTLOADER_TX: J3.23, J3.23B (23), U5.18 (P12)
GND: B1.GND, C1.2, C2.2, C3.2, C4.2, C5.2, C6.2, C7.2, C8.2, C9.2, C10.2, C11.2, C12.2, C13.2, C14.2, J1.5 (GND), J3.32, J3.32B (32), R4.2, R5.2, R6.1, U1.4 (VSS), U3.6 (GND), U5.13 (GND), U5.33 (GND), U5.34 (GND), U5.GND, X1.2 (GND), X1.4 (GND); also elsewhere on the board
I2C_SCL: J3.17, J3.17B (17), U5.5 (P01/AIN2)
I2C_SDA: J3.18, J3.18B (18), U5.11 (P07)
LED_BLUE: R1.1, U5.27 (P19)
LED_GREEN: R2.1, U5.28 (P20)
LED_RED: R3.1, U5.26 (P18)
unnamed: C5.1, U5.45 (P26/AIN0/XL2), X2.A (1)
unnamed: D1.2 (R), R3.2
unnamed: C3.1, U5.37 (XC1), X1.1
unnamed: C2.1, U5.38 (XC2), X1.3 (2)
unnamed: D1.4 (G), R2.2
unnamed: D1.3 (B), R1.2
unnamed: C4.1, U5.46 (P27/AIN1/XL1), X2.B (2)
unnamed: R4.1, U3.9 (VBACKUP)
unnamed: C10.1, U5.29 (DEC2)
unnamed: R5.1, U3.1 (CLKOE)
unnamed: C7.1, U5.39 (DEC1)
unnamed: B1.ANT1, U5.31 (ANT1)
unnamed: B1.ANT2, U5.32 (ANT2)
unnamed: B1.VCC (VDD_PA), C8.1, U5.30 (VDD_PA)
unnamed: C6.1, C13.1, L1.1, U5.35 (AVDD), U5.36 (AVDD)
unnamed: L1.2, L3.1
unnamed: L3.2, U5.2 (DCC)
P08: J3.19, J3.19B (19), U5.14 (P08)
P09: J3.20, J3.20B (20), U5.15 (P09)
P10: J3.21, J3.21B (21), U5.16 (P10)
P17: J3.2, J3.2B (2), U5.25 (P17)
P21: J3.6, J3.6B (6), U5.40 (P21)
P22: J3.7, J3.7B (7), U5.41 (P22)
P23: J3.8, J3.8B (8), U5.42 (P23)
P24: J3.9, J3.9B (9), U5.43 (P24)
RTC_CE: U3.8 (CE), U5.47 (P28)
SPI_MISO: J3.14, J3.14B (14), U1.2 (SO), U3.5 (MISO), U5.48 (P29)
SPI_MOSI: J3.15, J3.15B (15), U1.5 (SI), U3.10 (MOSI), U5.3 (P30)
SPI_SCK: J3.16, J3.16B (16), U1.6 (SCK), U3.4 (SCL), U5.4 (P00/AREF0)
SWDCLK: J1.4 (SWDCLK), J3.4, J3.4B (4), R6.2, U5.24 (SWDCLK)
SWDIO/!RESET: J1.2 (SWDIO), J3.3, J3.3B (3), J3.30, J3.30B (30), U5.23 (SWDIO/!RESET)
UNUSED1: J3.5, J3.5B (5)
UNUSED2: J3.10, J3.10B (10)
UNUSED3: J3.11, J3.11B (11)
UNUSED4: J3.12, J3.12B (12)
UNUSED5: J3.13, J3.13B (13)
VCC: C9.1, C11.1, C12.1, C14.1, D1.1 (VDD), J1.1 (VCC), J3.1, J3.1B (1), U1.8 (VDD), U3.2 (VCC), U5.1 (VDD), U5.12 (VDD); also elsewhere on the board

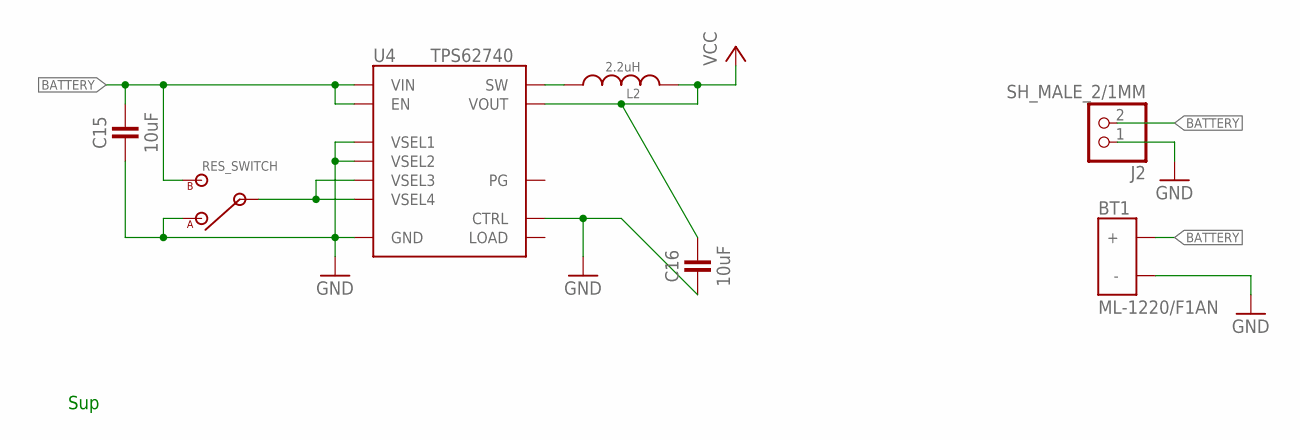
[picture p42: schematic nucleum.sch, sheet 2]

Parts:
BT1: ML-1220/F1AN; ML-1220/F1BN
C15, C16: 10uF; 0603_CAP; DIGIKEY 490-7316-1-ND
J2: SH_MALE_2/1MM; SH-1X2/1MM
L2: 2.2uH; MIPSZ201D
S1: RES_SWITCH
U4: TPS62740; R-PWSON-12

Connections:
BATTERY: BT1.POS (+), C15.1, J2.2, S1.B, U4.1 (VIN), U4.12 (EN); also elsewhere on the board
GND: BT1.NEG (-), C15.2, C16.2, J2.1, S1.A, U4.3 (GND), U4.4 (CTRL), U4.10 (VSEL2), U4.11 (VSEL1), U4.NC (GND); also elsewhere on the board
unnamed: L2.1, U4.2 (SW)
unnamed: S1.C (IN), U4.8 (VSEL4), U4.9 (VSEL3)
VCC: C16.1, L2.2, U4.5 (VOUT); also elsewhere on the board

Notes on the sheet:
Sup

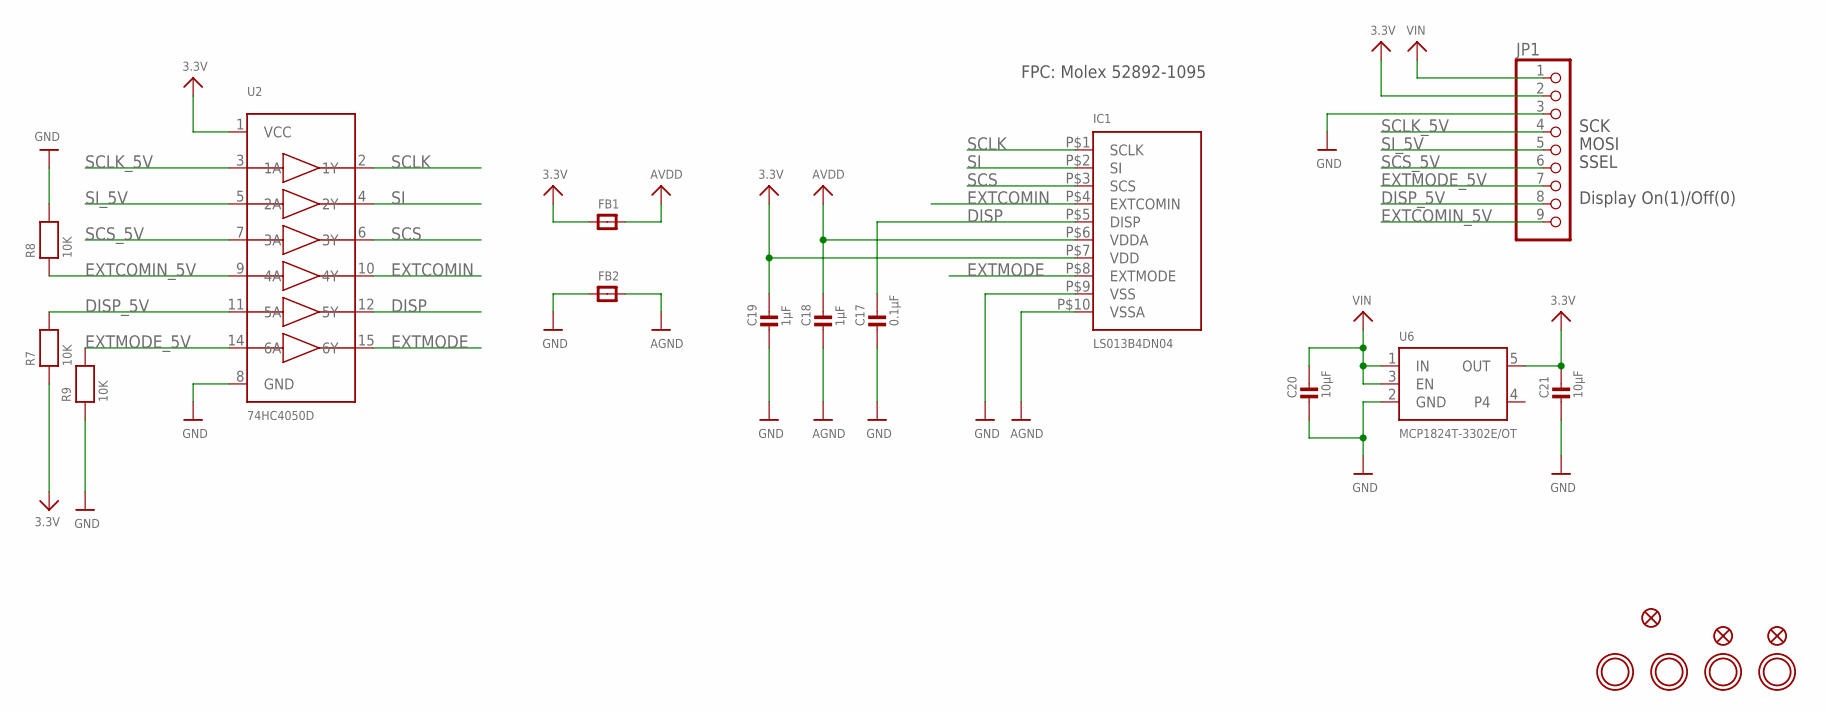
[picture p43: schematic nucleum.sch, sheet 3]

Parts:
C17: 0.1µF; _0805
C18, C19: 1µF; _0805
C20, C21: 10µF; _0805
FB1, FB2: FERRITE_0805; _0805
FID1, FID2, FID3: FIDUCIAL""; FIDUCIAL_1MM
IC1: LS013B4DN04; FPC_10PIN_52892-1095
JP1: HEADER-1X970MIL; 1X09_ROUND_70
R7, R8, R9: 10K; _0805
U2: 74HC4050D; SOIC16
U6: MCP1824T-3302E/OT; SOT23-5
U$21, U$22, U$27, U$28: MOUNTINGHOLE3.0THIN; MOUNTINGHOLE_3.0_PLATEDTHIN

Connections:
3.3V: C19.1, C21.1, FB1.1, IC1.P$7 (VDD), JP1.2, R7.1, U2.1 (VCC), U6.5 (OUT)
AGND: C18.2, FB2.2, IC1.P$10 (VSSA)
AVDD: C18.1, FB1.2, IC1.P$6 (VDDA)
DISP: C17.1, IC1.P$5 (DISP), U2.12 (5Y)
DISP_5V: JP1.8, R7.2, U2.11 (5A)
EXTCOMIN: IC1.P$4 (EXTCOMIN), U2.10 (4Y)
EXTCOMIN_5V: JP1.9, R8.1, U2.9 (4A)
EXTMODE: IC1.P$8 (EXTMODE), U2.15 (6Y)
EXTMODE_5V: JP1.7, R9.2, U2.14 (6A)
GND: C17.2, C19.2, C20.2, C21.2, FB2.1, IC1.P$9 (VSS), JP1.3, R8.2, R9.1, U2.8 (GND), U6.2 (GND); also elsewhere on the board
SCLK: IC1.P$1 (SCLK), U2.2 (1Y)
SCLK_5V: JP1.4, U2.3 (1A)
SCS: IC1.P$3 (SCS), U2.6 (3Y)
SCS_5V: JP1.6, U2.7 (3A)
SI: IC1.P$2 (SI), U2.4 (2Y)
SI_5V: JP1.5, U2.5 (2A)
VIN: C20.1, JP1.1, U6.1 (IN), U6.3 (EN)

Notes on the sheet:
SSEL
MOSI
SCK
Display On(1)/Off(0)
FPC: Molex 52892-1095

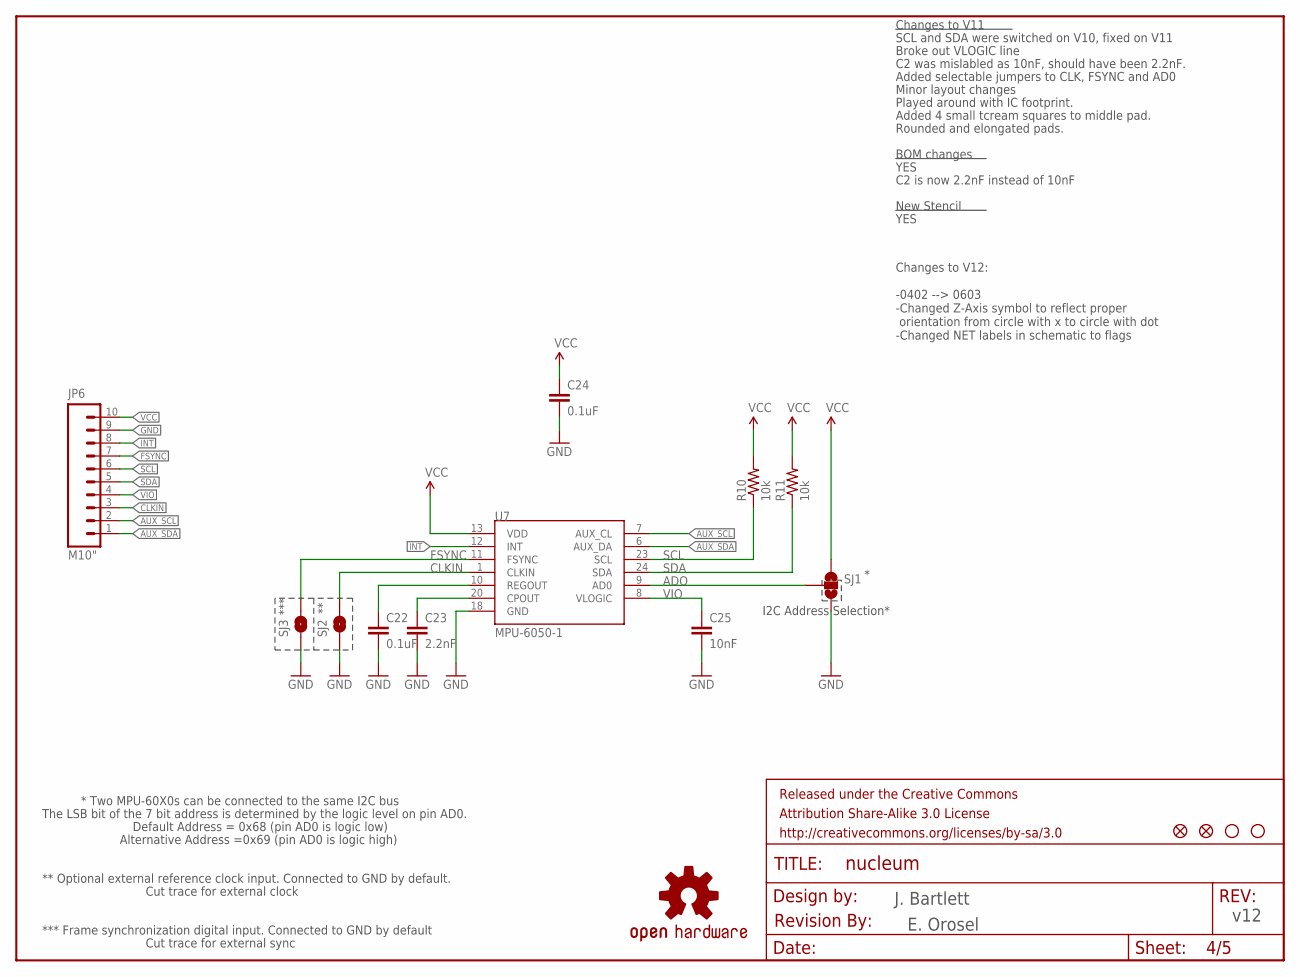
[picture p44: schematic nucleum.sch, sheet 4]

Parts:
C22, C24: 0.1uF; 0603-CAP
C23: 2.2nF; 0603-CAP
C25: 10nF; 0603-CAP
FRAME4: FRAME-LETTER; CREATIVE_COMMONS
JP2, JP5: FIDUCIALUFIDUCIAL; MICRO-FIDUCIAL
JP3, JP4: STAND-OFFTIGHT; STAND-OFF-TIGHT
JP6: M10"; 1X10
R10, R11: 10k; 0603-RES
SJ1: SOLDERJUMPER_2WAYPASTE2&3; SJ_3_PASTE2&3
SJ2, SJ3: SOLDERJUMPERTRACE; SJ_2S-TRACE
U7: MPU-6050-1; QFN-24-4MM2
U$30: OSHW-LOGOS; OSHW-LOGO-S
U$31: REVISION

Connections:
ADO: SJ1.2, U7.9 (AD0)
AUX_SCL: JP6.2, U7.7 (AUX_CL)
AUX_SDA: JP6.1, U7.6 (AUX_DA)
CLKIN: JP6.3, SJ2.2, U7.1 (CLKIN)
FSYNC: JP6.7, SJ3.2, U7.11 (FSYNC)
GND: C22.2, C23.2, C24.2, C25.2, JP6.9, SJ1.3, SJ2.1, SJ3.1, U7.18 (GND); also elsewhere on the board
INT: JP6.8, U7.12 (INT)
unnamed: C23.1, U7.20 (CPOUT)
unnamed: C22.1, U7.10 (REGOUT)
SCL: JP6.6, R10.1, U7.23 (SCL)
SDA: JP6.5, R11.1, U7.24 (SDA)
VCC: C24.1, JP6.10, R10.2, R11.2, SJ1.1, U7.13 (VDD); also elsewhere on the board
VIO: C25.1, JP6.4, U7.8 (VLOGIC)

Notes on the sheet:
J. Bartlett
I2C Address Selection*
*** Frame synchronization digital input. Connected to GND by default
***
Cut trace for external sync
* Two MPU-60X0s can be connected to the same I2C bus
Default Address = 0x68 (pin AD0 is logic low)
Alternative Address =0x69 (pin AD0 is logic high)
The LSB bit of the 7 bit address is determined by the logic level on pin AD0.
** Optional external reference clock input. Connected to GND by default.
Cut trace for external clock
Changes to V11
SCL and SDA were switched on V10, fixed on V11
C2 was mislabled as 10nF, should have been 2.2nF.
Broke out VLOGIC line
BOM changes
New Stencil
YES
C2 is now 2.2nF instead of 10nF
Minor layout changes
Added selectable jumpers to CLK, FSYNC and AD0
Played around with IC footprint.
Changes to V12: -0402 --> 0603 -Changed Z-Axis symbol to reflect proper orientation from circle with x to circle with dot -Changed NET labels in schematic to flags
E. Orosel
v12
Added 4 small tcream squares to middle pad.
Rounded and elongated pads.

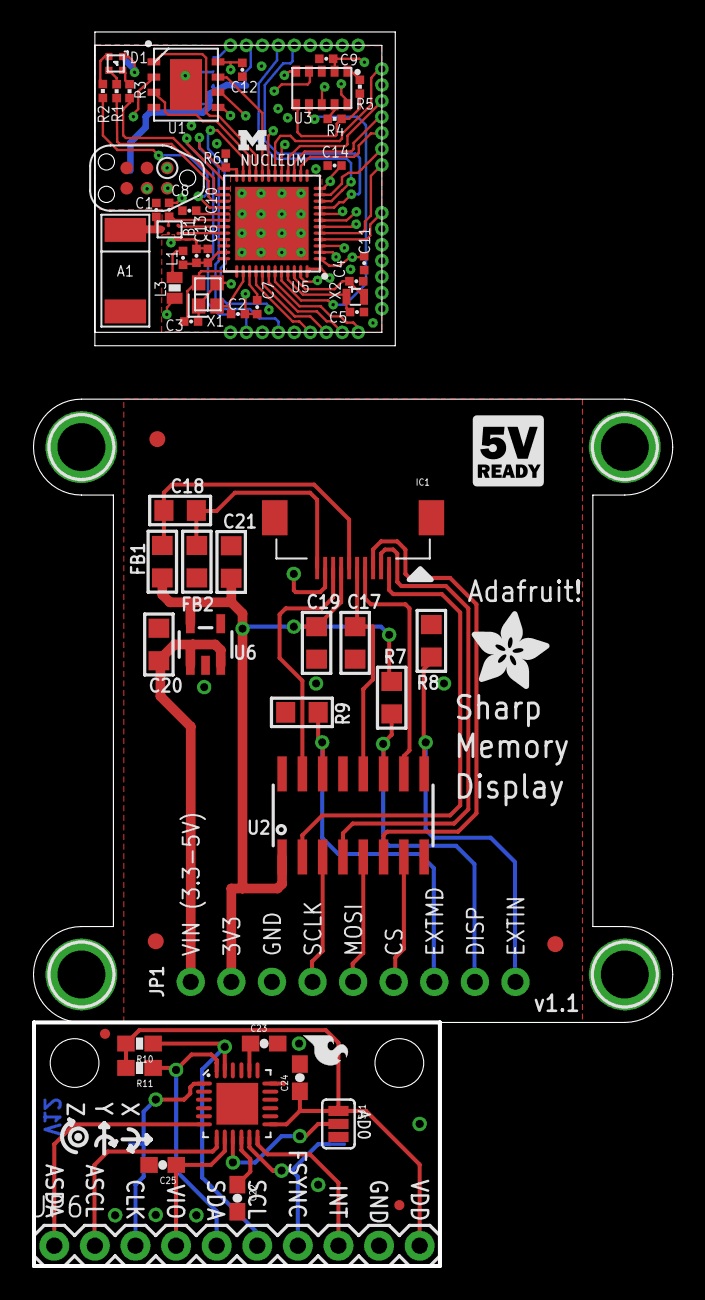
[picture p45: board nucleum.brd from above]

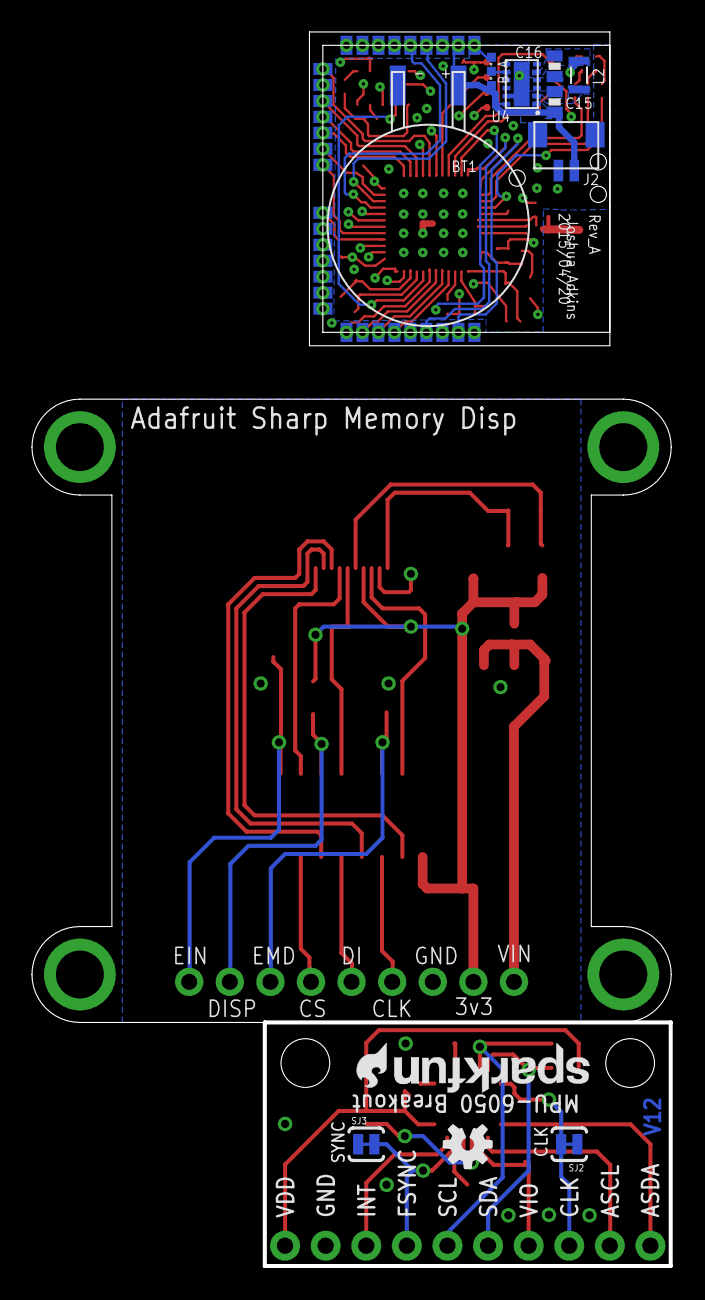
[picture p46: board nucleum.brd from below]

Board: 4 copper layers, 40.0 x 77.2 mm, 84 parts (12 on the bottom side), 86 nets.

Other parts of the board:
U$19: LOGIC_5VREADY_5MM
U$29: ADAFRUIT_5MM
U$32, U$33: SFE-LOGO-FLAME
U$34: SFE-NEW-WEB
