sloboste/eecs473-fitness-watch/EAGLE/project/473/Adafruit_SharpMemoryDisplay.brd

## EAGLE design EAGLE/project/473/Adafruit_SharpMemoryDisplay.brd (2015-11-10)

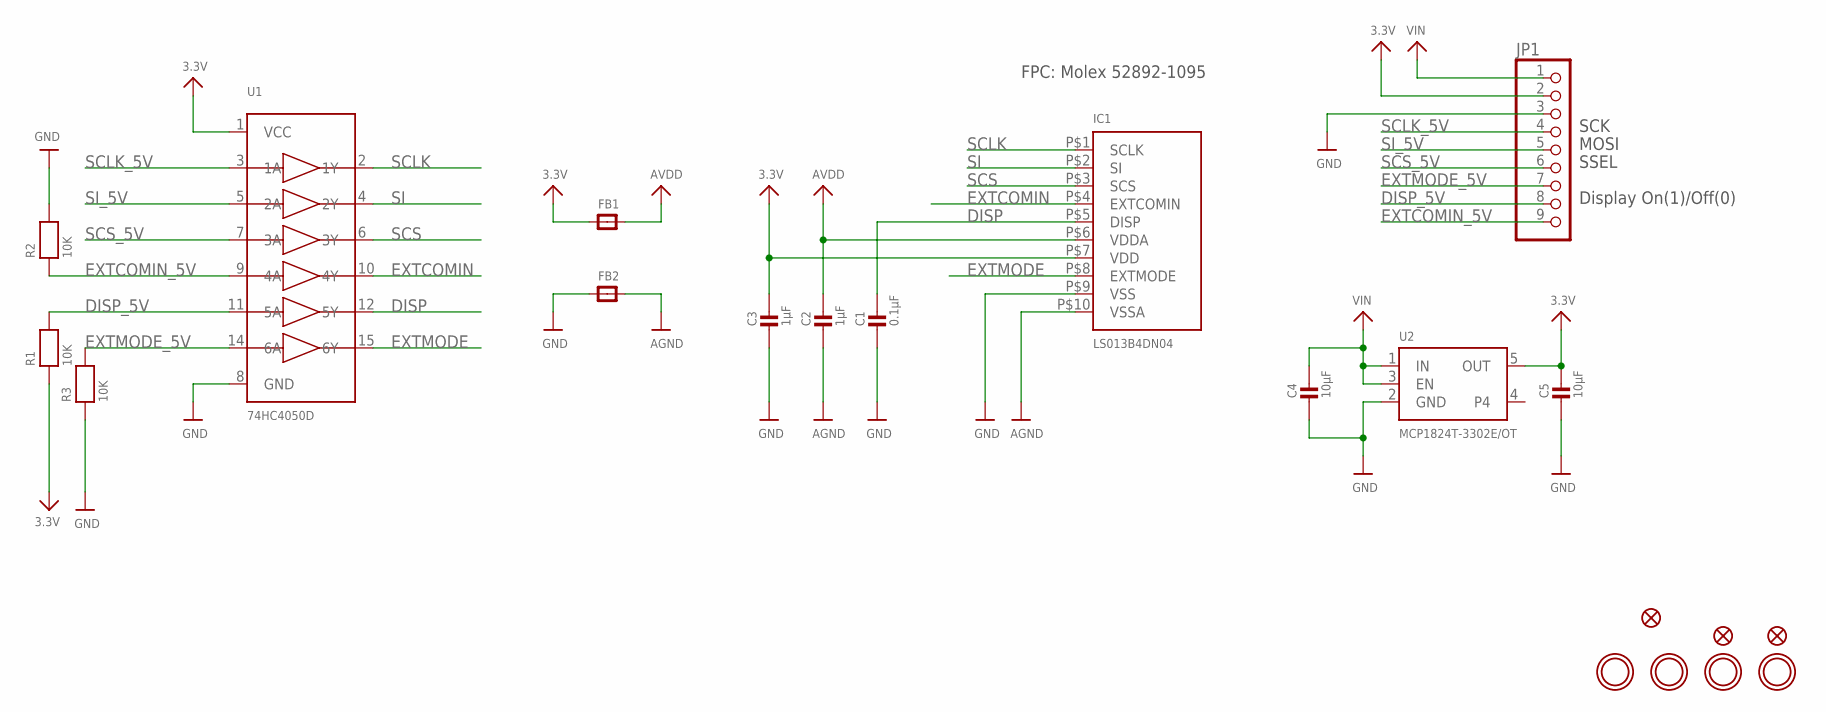
[picture p47: schematic Adafruit_SharpMemoryDisplay.sch]

Parts:
C1: 0.1µF; _0805
C2, C3: 1µF; _0805
C4, C5: 10µF; _0805
FB1, FB2: FERRITE_0805; _0805
FID1, FID2, FID3: FIDUCIAL""; FIDUCIAL_1MM
IC1: LS013B4DN04; FPC_10PIN_52892-1095
JP1: HEADER-1X970MIL; 1X09_ROUND_70
R1, R2, R3: 10K; _0805
U1: 74HC4050D; SOIC16
U2: MCP1824T-3302E/OT; SOT23-5
U$21, U$22, U$27, U$28: MOUNTINGHOLE3.0THIN; MOUNTINGHOLE_3.0_PLATEDTHIN

Connections:
3.3V: C3.1, C5.1, FB1.1, IC1.P$7 (VDD), JP1.2, R1.1, U1.1 (VCC), U2.5 (OUT)
AGND: C2.2, FB2.2, IC1.P$10 (VSSA)
AVDD: C2.1, FB1.2, IC1.P$6 (VDDA)
DISP: C1.1, IC1.P$5 (DISP), U1.12 (5Y)
DISP_5V: JP1.8, R1.2, U1.11 (5A)
EXTCOMIN: IC1.P$4 (EXTCOMIN), U1.10 (4Y)
EXTCOMIN_5V: JP1.9, R2.1, U1.9 (4A)
EXTMODE: IC1.P$8 (EXTMODE), U1.15 (6Y)
EXTMODE_5V: JP1.7, R3.2, U1.14 (6A)
GND: C1.2, C3.2, C4.2, C5.2, FB2.1, IC1.P$9 (VSS), JP1.3, R2.2, R3.1, U1.8 (GND), U2.2 (GND)
SCLK: IC1.P$1 (SCLK), U1.2 (1Y)
SCLK_5V: JP1.4, U1.3 (1A)
SCS: IC1.P$3 (SCS), U1.6 (3Y)
SCS_5V: JP1.6, U1.7 (3A)
SI: IC1.P$2 (SI), U1.4 (2Y)
SI_5V: JP1.5, U1.5 (2A)
VIN: C4.1, JP1.1, U2.1 (IN), U2.3 (EN)

Notes on the sheet:
SSEL
MOSI
SCK
Display On(1)/Off(0)
FPC: Molex 52892-1095

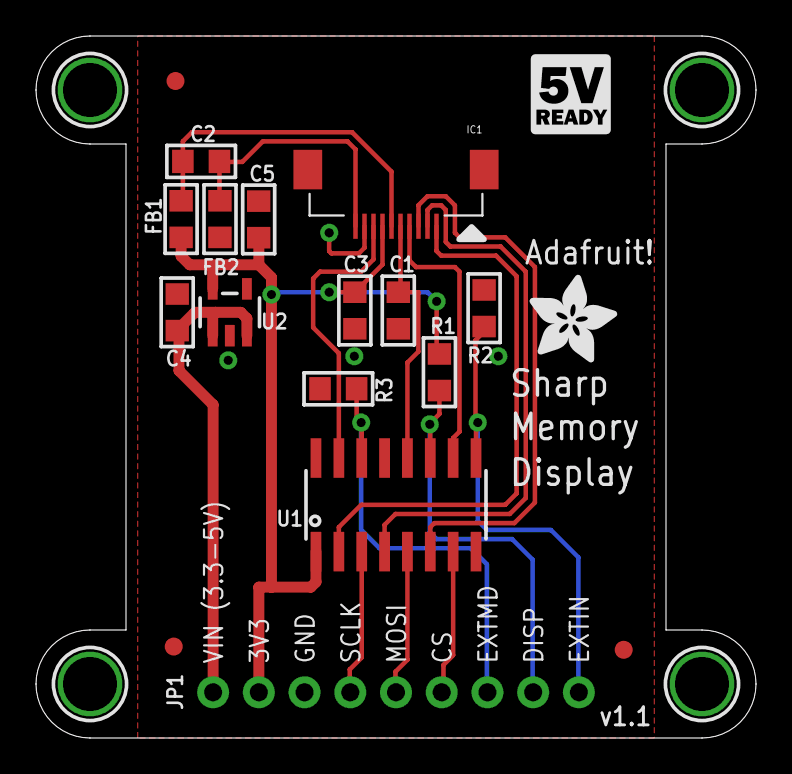
[picture p48: board Adafruit_SharpMemoryDisplay.brd from above]

Board: 2 copper layers, 40.0 x 39.0 mm, 23 parts (0 on the bottom side), 17 nets.

Other parts of the board:
U$19: LOGIC_5VREADY_5MM
U$29: ADAFRUIT_5MM
