sloboste/eecs473-fitness-watch/software/apps/watch/state_machine.c

/* This file is part of eecs473-fitness-watch.
 *   
 * The code / board schematics created by the authors of eecs473-fitness-watch
 * are free software/hardware: you can redistribute them and/or modify them
 * under the terms of the GNU General Public License as published by the Free
 * Software Foundation, either version 3 of the License, or (at your option)
 * any later version.
 *
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
 * All code / schematics not created by the authors of this repository fall
 * under their original licenses.
 */

#include <stdint.h>
#include <stdbool.h>

#include "softdevice_handler.h"
#include "nrf_delay.h"

#include "state_machine.h"
#include "lcd_builder.h"
#include "lcd_driver.h"
#include "ble_config.h"
#include "date_time.h"
#include "scheduler_config.h"
#include "timer_config.h"
#include "flash.h"
#include "watch_data.h"
#include "gps.h"

#include "boards.h" // FIXME remove
#include "nrf_gpio.h" // FIXME remove


// The current state of the state machine
static enum state_machine_state_enum current_state;


void state_machine_init()
{
    lcd_clearDisplay();
    current_state = STATE_WATCH_FACE;

    lcd_builder_init();
    watch_data_init();
    flash_load_step_count(&watch_data_step.steps_offset);
    watch_data_step.steps = watch_data_step.steps_offset;
    flash_load_step_yesterday(&watch_data_step.yesterday_steps);
    flash_load_step_goal(watch_data_step.goal);
    
    state_machine_refresh_screen();
}

void state_machine_refresh_screen()
{
    switch (current_state) {
        case STATE_WATCH_FACE:
            lcd_builder_build_watch_face();
            break;

        case STATE_STEPS:
        case STATE_STEPS_GOAL:
            lcd_builder_build_steps();
            break;

        case STATE_RUN_TIMER_OFF:
        case STATE_RUN_TIMER_ON:
            lcd_builder_build_run();
            break;

        case STATE_GPS:
            lcd_builder_build_gps();
            break;

        case STATE_STOPWATCH_TIMER_OFF:
        case STATE_STOPWATCH_TIMER_ON:
            lcd_builder_build_stopwatch();
            break;

        default: // ERROR
            break;
    }
    lcd_refresh();
}

void state_machine_on_ble_adv_con(uint8_t ble_state)
{
    watch_data_bluetooth_state = ble_state;
    app_sched_event_put(NULL, 0, state_machine_refresh_screen);
}

// Cycle
void state_machine_on_button_0()
{
    switch (current_state) {
        case STATE_WATCH_FACE:
            current_state = STATE_STEPS;
            lcd_clearDisplay();
            state_machine_refresh_screen();
            break;

        case STATE_STEPS:
            current_state = STATE_RUN_TIMER_OFF;
            lcd_clearDisplay();
            state_machine_refresh_screen();
            break;

        case STATE_STEPS_GOAL:
            // Cycle numbers in step goal
            if (++watch_data_step.goal[lcd_builder_step_goal_digit] > '9') {
                watch_data_step.goal[lcd_builder_step_goal_digit] = '0';
            }
            state_machine_refresh_screen();
            break;

        case STATE_RUN_TIMER_OFF:
            current_state = STATE_GPS;
            //timer_stop_1hz_periodic_0(); // FIXME remove
            if (!watch_data_gps_logging_on) {
                gps_enable();
            }
            lcd_clearDisplay();
            state_machine_refresh_screen();
        
            /* FIXME remove 
            gps_info_t gps_info;
            while (1) {
                switch (gps_get_info(&gps_info)) {                                          
                    case GPS_TYPE_GPRMC:
                        strcpy(watch_data_gps.longitude, gps_info.longitude);               
                        strcpy(watch_data_gps.latitude, gps_info.latitude);                 
                        watch_data_gps.ground_speed =
                            (uint32_t) (KNOT_IN_METERS_PER_SECOND * gps_info.speed);           

                        state_machine_refresh_screen();
                        break;
                    case GPS_TYPE_GPGGA:
                        strcpy(watch_data_gps.longitude, gps_info.longitude);               
                        strcpy(watch_data_gps.latitude, gps_info.latitude);                 
                        watch_data_gps.altitude = gps_info.altitude;                        
    
                        state_machine_refresh_screen();
                        break;
                }        
            }
            */ 
            break;

        case STATE_RUN_TIMER_ON:
            // Run timer reset
            current_state = STATE_RUN_TIMER_OFF;
            timer_stop_1hz_periodic_1();
            watch_data_run.timer_running = false;
            lcd_builder_build_run();
            state_machine_refresh_screen();
            break;

        case STATE_GPS:
            current_state = STATE_STOPWATCH_TIMER_OFF;
            if (!watch_data_gps_logging_on) {
                gps_disable();
            }
            //timer_start_1hz_periodic_0(); // FIXME remove
            lcd_clearDisplay();
            state_machine_refresh_screen();
            break;

        case STATE_STOPWATCH_TIMER_OFF:
            current_state = STATE_WATCH_FACE;
            lcd_clearDisplay();
            state_machine_refresh_screen();
            break;

        case STATE_STOPWATCH_TIMER_ON:
            // Lap timer 
            watch_data_stopwatch_timer_lap();
            break;

        default: // ERROR
            // No effect 
            break;
    }
}

// Select
void state_machine_on_button_1()
{
    switch (current_state) {
        case STATE_WATCH_FACE:
            if (watch_data_bluetooth_state == BLE_STATE_ADVERTISING) {
                ble_advertising_stop();
            } else if (watch_data_bluetooth_state == BLE_STATE_IDLE) {
                ble_advertising_start();
            }
            state_machine_refresh_screen();
            break;

        case STATE_STEPS:
            // Go to goal setting
            current_state = STATE_STEPS_GOAL;
            lcd_builder_step_goal_digit = 0;
            state_machine_refresh_screen();
            break;

        case STATE_STEPS_GOAL:
            // Go to next goal digit
            if (++lcd_builder_step_goal_digit > 4) {
                current_state = STATE_STEPS;
            }
            state_machine_refresh_screen();
            break;

        case STATE_RUN_TIMER_OFF:
            // Start timer
            current_state = STATE_RUN_TIMER_ON;
            watch_data_run_timer_reset();
            timer_start_1hz_periodic_1(); 
            watch_data_run.timer_running = true;
            state_machine_refresh_screen();
            break;

        case STATE_RUN_TIMER_ON:
            // Pause or restart timer
            if (watch_data_run.timer_running) {
                timer_stop_1hz_periodic_1();
                watch_data_run.timer_running = false;
            } else {
                timer_start_1hz_periodic_1();
                watch_data_run.timer_running = true;
            }
            state_machine_refresh_screen();
            break;

        case STATE_GPS:
            // Enable or disable gps logging
            if (watch_data_gps_logging_on) {
                gps_stop_logging();
                watch_data_gps_logging_on = false;
            } else {
                gps_erase_log();
                gps_start_logging();
                watch_data_gps_logging_on = true;
            }
            state_machine_refresh_screen();
            break;

        case STATE_STOPWATCH_TIMER_OFF:
            watch_data_stopwatch_timer_reset();
            timer_start_10hz_periodic();
            current_state = STATE_STOPWATCH_TIMER_ON;
            break;

        case STATE_STOPWATCH_TIMER_ON:
            timer_stop_10hz_periodic();
            current_state = STATE_STOPWATCH_TIMER_OFF;
            break;

        default: // ERROR
            break;
    }

}

// Power off
void state_machine_on_button_2()
{
    // Note: It hardfaults if this delay is not here. Maybe because of a
    // timer interrupt that goes off before the system has a chance to finish
    // shutting down. 
    lcd_clearDisplay();
    lcd_builder_build_sleep_message();
    lcd_refresh();
    if (watch_data_gps_logging_on) {
        gps_stop_logging();
        watch_data_gps_logging_on = false;
    }
    flash_store_date_time(&date_time);
    flash_store_step_count(&watch_data_step.steps);
    flash_store_step_yesterday(&watch_data_step.yesterday_steps);
    flash_store_step_goal(watch_data_step.goal);
    nrf_delay_ms(1000);
    lcd_clearDisplay();
    sd_power_system_off();
    // Never returns
}
