sloboste/eecs473-fitness-watch/software/apps/rtc/time_keeper.c

#include <stdbool.h>
#include <stddef.h>
#include "nrf.h"
#include "nrf_gpio.h"
#include "nrf_soc.h"
#include "app_util_platform.h"
#include "time_keeper.h"

void rtc_config(void)
{
  NVIC_EnableIRQ(RTC0_IRQn);                                 // Enable Interrupt for the RTC in the core
  NRF_RTC0->PRESCALER = COUNTER_PRESCALER;                   // Set prescaler to a TICK of RTC_FREQUENCY
  NRF_RTC0->CC[0] = COMPARE_COUNTERTIME * (RTC_FREQUENCY/2);     // Compare0 after approx COMPARE_COUNTERTIME seconds

  // Enable TICK event and TICK interrupt:
  NRF_RTC0->EVTENSET = RTC_EVTENSET_TICK_Msk;
  NRF_RTC0->INTENSET = RTC_INTENSET_TICK_Msk;

  // Enable COMPARE0 event and COMPARE0 interrupt:
  NRF_RTC0->EVTENSET = RTC_EVTENSET_COMPARE0_Msk;
  NRF_RTC0->INTENSET = RTC_INTENSET_COMPARE0_Msk;

  curr_time.hours = 0;
  curr_time.minutes = 0;
  curr_time.seconds = 0;
  curr_time.milli = 0;
}

void RTC0_IRQHandler()
{
  if ((NRF_RTC0->EVENTS_TICK != 0) && ((NRF_RTC0->INTENSET & RTC_INTENSET_TICK_Msk) != 0))
  {
    NRF_RTC0->EVENTS_TICK = 0;
    //do something on a tick here
    nrf_gpio_pin_toggle(18);
  }
  if ((NRF_RTC0->EVENTS_COMPARE[0] != 0) && ((NRF_RTC0->INTENSET & RTC_INTENSET_COMPARE0_Msk) != 0))
  {
    NRF_RTC0->EVENTS_COMPARE[0] = 0;
    NRF_RTC0->TASKS_CLEAR = 1;
    //do something every  millisecond here
    update_curr_time();
    nrf_gpio_pin_toggle(19);
    
  }
}

void set_time(uint8_t hours, uint8_t minutes, uint8_t seconds, uint8_t milli){
  CRITICAL_REGION_ENTER();
  curr_time.hours = hours;
  curr_time.minutes = minutes;
  curr_time.seconds = seconds;
  curr_time.milli = milli;
  CRITICAL_REGION_EXIT();
}

current_time_t get_time(){
  return curr_time;
}

void update_curr_time(){
  CRITICAL_REGION_ENTER();
  curr_time.milli++;
  if(curr_time.milli == 100){
    curr_time.seconds++;
    curr_time.milli = 0;
  }
  if(curr_time.seconds == 60){
    curr_time.minutes++;
    curr_time.seconds = 0;
  }
  if(curr_time.minutes == 100){
    curr_time.hours++;
    curr_time.minutes = 0;
  }
  if(curr_time.hours == 24){
    curr_time.seconds = 0;
    curr_time.minutes = 0;
    curr_time.hours = 0;
    curr_time.milli = 0;
  }
  CRITICAL_REGION_EXIT();
}
