sloboste/eecs473-fitness-watch/(commit log)

2015-10-08 imu hardware interface
2015-10-08 Add battery coulomb counter interface.
2015-10-08 Clean up style in IMU interface.
2015-10-08 Adding .h interface to Heart Rate Monitor and adding Android API prototype
2015-10-28 Eagle files
    [nucleum.brd, nucleum.sch]
2015-10-28 changed to sheet 2 test
    [nucleum.sch]
2015-10-29 lipo testing stuff
    [lipo_charger.brd, lipo_charger.sch]
2015-10-29 PCB Schematic
    [AdafruitUltimateGPS.sch, Adafruit_SharpMemoryDisplay.brd, Adafruit_SharpMemoryDisplay.sch, PulseSensorAmpd_1.sch, Triple_Axis_Accelerometer-Gyro_Breakout-MPU-6050_v12.brd, Triple_Axis_Accelerometer-Gyro_Breakout-MPU-6050_v12.sch, fitnessband.sch, mpu6050.sch]
2015-10-29 PCB update
    [fitnessband.sch]
2015-10-30 Add header for common things on the green dev board.
2015-10-30 I'm tired so I'm not writing a good commit message
    [fitnessband.sch]
2015-10-30 combined sheets
    [fitnessband.sch]
2015-10-30 Working on device connection...
2015-10-31 Heart rate and battery services work. Code is still messy and needs cleanup. This will be addressed later.
2015-10-31 Clean up battery and heart rate service code.
2015-11-01 began layot
    [fitnessband.brd, fitnessband.sch]
2015-11-02 Untested IMU code
2015-11-02 Don't let device name be updated.
2015-11-03 bill of materials
2015-11-04 FIFO scheduling with LEDs
2015-11-04 no airwires or drc errors
    [fitnessband.brd, fitnessband.sch]
2015-11-04 Add common #defines for blue dev board.
2015-11-05 Add UART pins to blue_dev_board defines.
2015-11-05 Add UART pin defines to green_dev_board.h
2015-11-06 IMU and Makefiles
2015-11-07 Update UART pin defines for blue board.
2015-11-09 initial solidworks parts and assembled pcb
    [assembled_pcb.SLDASM, battery.SLDPRT, battery_port.SLDPRT, gps.SLDPRT, headers.SLDPRT, microusb.SLDPRT, pcb.SLDPRT]
2015-11-09 I don't know the diff
    [assembled_pcb.SLDASM]
2015-11-09 double tap interrupt generation
2015-11-10 made headers shorter, will need to cut down
    [headers.SLDPRT]
2015-11-10 added leds
    [pcb.SLDPRT]
2015-11-10 new parts
    [button.SLDPRT, lcd.SLDPRT]
2015-11-10 started bottom case
    [bottom_case.SLDPRT]
2015-11-10 putting it all together
    [All.SLDASM, assembled_pcb.SLDASM]
2015-11-10 IMU interface
2015-11-10 Questionable GPIO interrupt
2015-11-10 LCD Interface - named spi attempt will change
2015-11-11 Move timer configuration to lib/timer.
2015-11-11 Move uart_adapter to lib/uart
2015-11-11 Add green dev board pinout to docs.
2015-11-11 Clean up battery_service code.
2015-11-11 Clean up the UART code.
2015-11-11 Begin cleaning up gps driver code.
2015-11-11 Scheduler works along side softdevice. Blinks led and updates ble characteristics at 1/2 Hz. Timer/scheduler config code needs cleanup and modification for consistency.
2015-11-12 Abstract some of the scheduler/timer internals into config files.
2015-11-12 using pins
    [All.SLDASM, assembled_pcb.SLDASM, bottom_case.SLDPRT, top_case.SLDPRT]
2015-11-12 Use RTC0 to keep track of milliseconds and created draft of time_keeper.h and time_keeper.c, some testing still needed but mostly complete
2015-11-12 Change target in IMU makefile to be GREEND_DEV_BOARD
2015-11-12 Move imu stuff to lib/imu. NOTE: nrf_driver_config.h is still needed in the application folder.
2015-11-12 Commment out segger includes and printfs.
2015-11-12 Imu step count integrated into app.
2015-11-12 Forgot to add nrf_drv_config.h (neccessary for imu).
2015-11-12 Add eval board docs.
2015-11-13 Move SPI pin defines to platform board file
2015-11-13 Add i2c pins to nrf_drv_config
2015-11-13 Update nrf5x-base with I2C pin change
2015-11-13 Update lcd driver to not use globals and add steps to watch face for demo.
2015-11-13 Got softdevice with imu, lcd, pedometer working.
2015-11-13 Add gps to demo app. So getting data from the gps causes problems... But at least we can load the GPS driver without RAM overflowing into stacks space! The gps driver bug is my fault :(
    [main.c]
2015-11-21 Button interrupts and screen switching. Button interrupts now work using the nordic gpiote module. Began a state machine that transitions in response to a button press so that we can switch between s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
2015-11-21 WIP bluetooth advertise start/stop on button push
2015-11-21 WIP timer screen
2015-11-22 Basic timer with 10th second resolution (best we can do).
2015-11-22 Add lap timing and reset. Note: the lcd_builder code needs some style cleanup
    [main.c, state_machine.c]
2015-11-23 Run screen timer.
2015-11-23 Clean up timer_config.
2015-11-23 Add note about low power wait.
2015-11-24 Fix typo in request handler.
    [main.c]
2015-11-24 Make apps/ble into test app for BLE on our PCB.
2015-11-24 changes from rev2
    [fitnessband.brd, fitnessband.sch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]
2015-11-25 Add button test. Note: must change pin definitions for pcb.
2015-11-25 Button test works on pcb.
2015-11-25 System off/wakeup on button press. Note: when persistent storage is implemented, we will need to save the state before shutting down.
2015-11-26 Tapping read once will set of notifications. Subsequently tapping write will request data for 04 (battery level)
2015-11-29 add led blink to imu test
2015-11-29 use bluetooth and led to show step count.
2015-11-30 rev2 WIP
    [All.SLDASM, assembled_pcb.SLDASM, bottom_case.SLDPRT, lcd.SLDPRT, top_case.SLDPRT]
2015-11-30 Update imu_test
2015-11-30 Updated IMU address
2015-11-30 Fuel gauge works with dev board.
2015-11-30 Add hardware quickstart function to fuel gauge to ensure that it is accurate every time power comes on.
2015-12-01 Correct pcb sw i2c pin assignments.
    [main.c]
2015-12-02 continuously get battery level and display it with updated UI with packet parsing
2015-12-03 Try to fix flash bug with more delay, send fake gps data over ble.
    [flash.c, main.c]
2015-12-04 added uart pins
2015-12-08 Added Google maps button
2015-12-08 Restructure watch data, fix pin LCD pin assignemnt, use boards.h for universal pin assignemnts. Restructuring the watch data means move it out of lcd_builder so each module looks at the watch_data fi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
    [boards.h, date_time.c, flash.c, flash.h, main.c, nrf_drv_config.h, state_machine.c, twi_master_config.h]
2015-12-08 Give imu step functions pedometer prefix.
2015-12-08 Fix gps data screen
    [watch_data.c]
2015-12-08 lcd driver flip bitmap
2015-12-09 Got log dump to the point where it won't crash the app
    [main.c]
2015-12-09 Added view route button with Copying text
2015-12-09 GPS log dump works on PCB
2015-12-09 GPS log works with parser (still has debug leds).
2015-12-10 GPS data/time works (need to remove debug leds).
2015-12-10 Take out debug leds, fix comments
    [date_time.h, main.c]
2015-12-10 Day of demo fixes (date loading/storing broke.
    [date_time.c, flash.c, main.c, state_machine.c]
